zfrkrc/robocat/docs/README.md

# RoboCat dokümantasyon merkezi

| Bakmak istediğin | Belge |
|---|---|
| **Adım adım uygulama** | **[Kılavuz](KILAVUZ.md)** |
| **Kurulum (yazılım/elektronik/mekanik)** | **[Kurulum](KURULUM.md)** |
| **Parça listesi + bağlantı matrisi** | **[Bağlantı şablonu](BAGLANTI.md)** |
| Ürün ilanı metni ve görseller | [İlan paketi](SITE_ILAN.md) |
| Hedef görünüm ve gerçek CAD | [Görsel galeri](GALLERY.md) |
| Gerçek proje/donanım fotoğrafları | [20 kare + teşhis notları](BUILD_PHOTOS_2026-10-26.md) |
| Çevre sensör düğümü (ESP32) | [Bağlantı şeması ve pin tablosu](ENV_NODE.md) |
| Güncel mimari / görev dağılımı | [Sistem](SYSTEM.md) |
| Tek LiPo ve güç yolu | [Güç diyagramı](images/robocat-power.svg), [güncel güç planı](../hardware/PCB_PLAN_REV_A.md) |
| Aldığımız parçalar | [Envanter](../hardware/INVENTORY.md) |
| Pin adayları | [PINMAP_REV_A.csv](../hardware/PINMAP_REV_A.csv) |
| Ne basılacak / ne bekleyecek | [Baskı merkezi](PRINTING.md) |
| Eski sürümler ve ayrı projeler | [Arşiv merkezi](../archive/README.md) |
| Orijinal dosyalar ve lisans sınırları | [Kaynak haritası](SOURCES.md) |
| Aşamalar ve tamamlanma ölçütleri | [Yol haritası](ROADMAP.md) |

Güncel durum: mekanik uyum baskısı ve masaüstü elektronik test hazırlığı. Tam yürüyen robot, bitmiş kol veya üretilebilir PCB iddiası yoktur. Belgelerdeki mimari/pin tablosu gerçek bağlantı ve bileşen kontrollerinden önce uygulanmış devre sayılmaz.
