zfrkrc/robocat/custom/README.md

# RoboCat özel mekanik dosyaları

## Güncel girişler

| Dizin | Rol |
|---|---|
| [petg-stage-v0.5](petg-stage-v0.5/README.md) | Önce metalik PETG: altı tek-parça uyum işi, düzeltilmiş CAT06B |
| [print-fit-v0.4](print-fit-v0.4/README.md) | Genel uyum listesi ve boş LiPo tepsisi |
| [robocat-v0.3](robocat-v0.3/README.md) | Hâlâ kullanılan kafa CAD/STL/STEP kaynakları; tüm klasör baskı listesi değildir |
| [zk-v0.1](zk-v0.1/README.md) | Eski sensör ve 18650 prototipleri; güncel baskıda kullanılmaz |

Sürüm numarası daha eski diye v0.3 ve v0.4 kaynakları arşive taşınmadı: güncel göz ve baskı aşamaları bunlara başvuruyor. Dosya yolları ve script bağımlılıkları korunur.

**Baskı seçimi:** önce [v0.5 iş listesi](petg-stage-v0.5/metallic_queue.json), gerektiğinde [v0.4 manifesti](print-fit-v0.4/print_manifest.json). Klasördeki bütün STL'ler otomatik basılmaz. CAT10, BAT01 ve eski 18650 parçaları baskı dışıdır.

[Eski kaynak arşivi](../archive/README.md) · [Kurulum](../docs/KURULUM.md)
