zfrkrc/robocat/custom/zk-v0.1/README.md

# Eski RoboCat mekanik prototipleri — v0.1

**Tarihsel referans. Güncel baskı veya montaj seti değildir.**

| Dosya | Durum |
|---|---|
| `stl/03_shoulder_ultrasonic_x2.stl` | Omuz sensör braketi; nihai gövde montajı doğrulanmadı |
| `stl/04_3s_cassette_body_x2.stl` | Eski 18650 kaset gövdesi; tek LiPo kararında kullanılmaz |
| `stl/06_strap_dock_x2.stl` | Eski kaset kızağı; güncel baskıdan çıkarıldı |

STL içerikleri korunmuştur. Otomasyon bu klasörü tarayıp baskı başlatmamalıdır.

[Güncel PETG aşaması](../petg-stage-v0.5/README.md) · [Arşiv rehberi](../../archive/README.md)
