zfrkrc/robocat/Nova-SM3/STL Files/All Files/README.md

# All Files — eski / karışık referans seti

Bu dizin tarihsel kaynak olarak korunur; RoboCat'in güncel baskı listesi değildir. Eski ve güncel mekanik parçalar birlikte kullanılmamalıdır.

- Seçilen gövde seti: [SM3 Files](../SM3%20Files).
- İlk metalik PETG uyum aşaması: [v0.5](../../../custom/petg-stage-v0.5/README.md).
- Arşiv ve sürüm rehberi: [archive](../../../archive/README.md).

Mevcut STL dosyaları değiştirilmedi. Bu açıklama otomasyon için teknik bir engelleme mekanizması değildir.
