zfrkrc/robocat/docs/ROADMAP.md

# RoboCat / yol haritası

| Aşama | Mevcut durum | Tamamlanma ölçütü |
|---|---|---|
| Envanter | Sipariş listesinden kaydedildi | Fiziksel modeller/pinler/ölçüler doğrulanır |
| Baskı uyumu | Kafa parçaları CAD kontrolü, P1 kullanıcı tarafından basılıyor bildirimi | Gerçek servo, lens, kart ve vida ile kuru montaj |
| LiPo montajı | Tek LiPo kararı, boş tepsi prototipi | Gövde bağlantısı, kablo/koruma/sıkıştırmama ve titreşim kontrolü |
| Tek servo / tek bacak | Bekliyor | Kalibre yön/merkez/limit ve kararlı besleme |
| 12 bacak | Bekliyor | Destek üstünde hareket, akım/ısınma ölçümü, sonra yerde yavaş yürüyüş |
| Kameralar / merkez | Modüller envanterde, entegrasyon bekliyor | Gerçek görüntü akışı ve kontrollü hedef kaybı davranışı |
| Kol / kartvizit | Dört servo ayrıldı, mekanik tamamlanmadı | Sabit robotta erişim/tork ve yaylı uç denemesi |
| PCB | Yalnız mimari/pin planı | Test edilmiş netlist, seçili güç parçaları, şematik/PCB/ERC/DRC ve prototip |
| Koku/gaz | Sensörler envanterde | Isıl ayrım, besleme, kalibrasyon; genel koku tanıma iddiası olmadan ölçüm |

Önce mevcut modüllerle masaüstü test; sonra sonuçlara göre PCB. Yazıcıya, robota veya PCB üreticisine otomatik iş gönderildiği bu dokümantasyon güncellemesinden çıkarılmamalı.
