zfrkrc/robocat/docs/PENTEST_PROTOCOL.md

# RoboCat — pentest ajanı protokolü (v1)

`esp32.zk.net.tr` üzerindeki modül **yürüyen robot değil**, yetkili ağ testi yapan bir ajandır. Bu nedenle:

- **Yürüme komutları geçersiz:** `follow`, `hold`, `look`, `say`, `nose_extend` … bu role kapalıdır (422).
- Komut kümesi: **`scan` · `recon` · `report` · `pause` · `stop`**.
- Ajan bize **bulgu** gönderir; biz görev ve kapsam veririz.

> Kapsam (scope) zorunludur. `ROBO_PENTEST_SCOPE` tanımlı değilse **hiçbir tarama kabul edilmez** (409). Kapsam dışı hedef → **403**.

## 1) Rol bildirimi

`sync` gövdesine `role` ve `capabilities` eklenir:

```json
{"role":"pentest","capabilities":["tcp_scan","http_probe"],
 "firmware":"pentest-0.1","rssi":-55,"battery_v":11.8}
```

Sunucu role göre komut doğrular; `role` gönderilmezse `robot` varsayılır.

## 2) Görev alma

Aynı sync turu:

```json
{"commands":[{"id":12,"kind":"scan","params":{"target":"172.16.16.50","ports":"22,80,443"}}]}
```

| `kind` | `params` | Not |
|---|---|---|
| `scan` | `{"target":"10.0.0.5","ports":"22,80,443-445","mode":"tcp","max_rate":20,"timeout_ms":800}` | kapsam içinde olmalı |
| `recon` | `{"target":"zk.net.tr"}` | DNS/WHOIS/pasif |
| `report` | `{}` | özet iste |
| `pause` | `{}` | taramayı duraklat |
| `stop` | `{}` | tüm işi durdur |
| `ping` | `{}` | cihaz canlılık testi |
| `info` | `{}` | cihaz özeti (firmware, heap, uptime) |
| `led` | `{"on":true}` | durum LED'i |
| `wifi_scan` | `{"channel":6,"duration_ms":1500}` | pasif AP taraması (kanal 1–13, 200–10000 ms) |
| `reboot` | `{}` | cihazı yeniden başlat |

## 2b) Radyo testi (attack) — kontrollü uç

`attack` genel komut uçundan **geçmez** (422). Yalnız aşağıdaki zincirle çalışır:

```
1) POST /api/v1/robots/{id}/attack/arm          -> tek kullanımlık token (TTL 120 s)
2) POST /api/v1/robots/{id}/attack              {mode,bssid,channel,duration_s,token}
3) GET  /api/v1/robots/{id}/attack/status       -> aktif oturum, kalan süre, bütçe
4) POST /api/v1/robots/{id}/attack/stop         -> anında stop komutu
```

| Kontrol | Kural |
|---|---|
| Ana anahtar | `ROBO_ATTACK_ENABLE=1` değilse **403** |
| Hedef | `ROBO_ATTACK_BSSIDS` listesindeki BSSID'ler; değilse **403** |
| Token | Tek kullanım, 120 s TTL; geçersiz/kullanılmış → **401** |
| Süre | 5–`ROBO_ATTACK_MAX_S` (varsayılan 60, en çok 120) sn; aşarsa **422** |
| Eşzamanlılık | Aynı anda tek oturum; ikincisi **409** |
| Bekleme | `ROBO_ATTACK_COOLDOWN_S` (15 s) → **429** |
| Günlük bütçe | `ROBO_ATTACK_DAILY_MAX` (10) → **429** |
| E-stop | Açıkken **409**; her şey durur |
| Watchdog | Süre dolunca sunucu **stop** yollar, oturumu `expired` yapar |
| Denetim | `attack.arm/start/stop/expired` olayları `events` tablosuna yazılır |
| Hedef onayı | Panelde "Yakındaki AP'ler" listesinden seçilir (TTL 8 saat) veya `ROBO_ATTACK_BSSIDS` | 

**Hedef seçimi:** sunucu, cihazın `/scan` çıktısını `GET /api/v1/robots/{id}/nearby` ile proxy'ler
(BSSID + SSID + RSSI + kanal). Panelde **Onayla** dediğin BSSID hedef listesine girer; başka
hiçbir BSSID başlatılamaz. Cihaz URL'si env'den gelir: `ROBO_DEVICE_URLS=pentest-1:http://172.16.16.221`.

Modlar: `deauth` · `beacon` · `probe` · `rickroll` · `evil_twin`.

**Yasal/güvenlik notu:** Bu modlar kendi BSSID'lerinde kısa süreli test içindir. Deauth/beacon
yayını yakındaki cihazları da etkiler; yalnız **yazılı izin verilen** ağlarda, kısa süreyle ve
`ROBO_ATTACK_BSSIDS` listesini dar tutarak kullan. Üçüncü taraflara karşı kullanım suçtur.

Komut `ack` ile kapatılır (bir sonraki turda). TTL 30 s.

### Görev parametreleri (sunucu doğrular ve normalleştirir)

| Alan | Varsayılan | Sınır | Not |
|---|---|---|---|
| `target` | — | zorunlu | kapsam içinde olmalı (403) |
| `ports` | `22,80,443` | **≤1024 port**, 1–65535 | `"22,80,443-445"` biçimi; sunucu sıkıştırıp `port_count` ekler |
| `mode` | `tcp` | `tcp` · `http_head` | `http_head` = bağlan + `HEAD /` gönder |
| `max_rate` | `20` | 1–200 bağlantı/sn | ajanın hız sınırı |
| `timeout_ms` | `800` | 100–5000 | bağlantı zaman aşımı |

Sunucunun cihaza yolladığı normalize edilmiş örnek:

```json
{"target":"172.16.16.50","ports":"22,80,443-445","port_count":5,
 "mode":"tcp","max_rate":20,"timeout_ms":800}
```

Geçersiz parametre → **422**; kapsam dışı hedef → **403**; kapsam tanımsız → **409**.

## 3) Bulgu gönderme

```
POST /api/v1/device/{device_id}/findings
X-Device-Key: <key>
```

```json
{"items":[
  {"scan_id":"s-2026-10-27-1","target":"172.16.16.50","port":22,"proto":"tcp",
   "service":"ssh","version":"OpenSSH 8.2","severity":"medium",
   "title":"Eski OpenSSH sürümü","evidence":"banner: SSH-2.0-OpenSSH_8.2","cvss":5.3}
]}
```

| Alan | Kural |
|---|---|
| `target` | IP / alan adı (190 karaktere kadar) |
| `title` | 3–200 karakter |
| `severity` | `info` · `low` · `medium` · `high` · `critical` |
| `port` | 0–65535 (opsiyonel) |
| `evidence` | en fazla 2000 karakter — **ham çıktı, sır/PII koyma** |
| toplu | tur başına en fazla **200** kayıt |

Yanıt: `{"stored":1,"out_of_scope":0,"scope_configured":true}`

`in_scope=false` olan bulgular **silinmez**, işaretlenir (yanlış hedefe gitmeyi görürsün).

## 3b) Referans ajan

`tools/pentest_agent.py` (yalnız standart kütüphane):

```bash
python3 tools/pentest_agent.py --url https://robocat.zk.net.tr \
  --device-id pentest-1 --key <KEY> [--once] [--dry-run]
```

- TCP connect taraması + SSH/HTTP banner; **exploit yok, kimlik denemesi yok**.
- `max_rate` jeton kovasıyla uygulanır, `timeout_ms` bağlantıya geçer.
- Bulguları `POST /findings` ile gönderir, sonra `ack` verir (sonraki turda).
- `--dry-run`: ağa dokunmaz, yalnız görevi alıp `dry-run` notuyla kapatır.

## 4) Okuma

```
GET /api/v1/findings?device_id=pentest-1&severity=high&limit=100
GET /api/v1/devices            # role + capabilities + online
```

Panel: `https://robocat.zk.net.tr/` → **Pentest bulguları** tablosu.

## 5) Kapsam ayarı

```bash
# /etc/robocat/server.env
ROBO_PENTEST_SCOPE=172.16.16.0/24,zk.net.tr
sudo systemctl restart robocat-server
```
- CIDR (`10.0.0.0/24`) veya alan adı/sonek (`zk.net.tr`) yazılabilir.
- **Boş bırakılırsa tarama reddedilir** — bilinçli güvenli varsayılan.

## 6) Yetki ve sınırlar

- Yalnız **sahibi olduğun ağ/alan adları** kapsama alınmalı; üçüncü taraflara tarama yasal risk taşır.
- Anahtar cihaz bazlıdır; sızarsa `ROBO_DEVICE_KEYS` içinde döndür.
- Bulgular **kanıt** olarak ham metin tutar; parola/token/kamera görüntüsü gibi hassas veri gönderme.
- Ajan `stop` komutunu **ACK edilmese bile** uygulamalı; yerel durdurma her zaman önceliklidir.
- Sunucu tarafı bir **orkestrasyon** katmanıdır: exploit çalıştırmaz, yalnız görev verir ve sonucu saklar.
