zfrkrc/robocat/archive/README.md

# Eski kaynak arşivi

Düzenleme: 2026-10-27. Bu klasör otomatik baskı, robot firmware'i veya PCB üretim kaynağı değildir.

## Taşınan upstream projeler

| Proje | İçerik / neden burada |
|---|---|
| [Nova-SM2](upstream/Nova-SM2) | Önceki quadruped sürümü; seçilen gövde seti Nova-SM3 |
| [BlackWidow-Hexapod](upstream/BlackWidow-Hexapod) | Altı ayaklı ayrı proje |
| [RobotArm-6DOF](upstream/RobotArm-6DOF) | Ayrı altı eksenli kol; RoboCat koluna doğrulanmış aktarım değil |
| [Pot_ProtoBox](upstream/Pot_ProtoBox) | Ayrı kutu projesi |
| [Spectrum-Analyzer](upstream/Spectrum-Analyzer) | Ayrı ses/ışık projesi |

Klasörlerin mevcut dosyaları değiştirilmeden, alt dizin yapılarıyla taşındı. Eski kök yolları artık `archive/upstream/` altındadır. Git geçmişi ve kökteki [LICENSE](../LICENSE) korunur; üçüncü taraf lisans koşulları ayrıca geçerlidir. Eski indirme/yer imi yolları yerine bu indeksi kullanın.

## Yol bağımlılıkları nedeniyle yerinde tutulanlar

| Kaynak | Durum |
|---|---|
| [Nova-SM3](../Nova-SM3) | Güncel gövde ve Mega referansları burada; farklı kart/sürüm dosyaları da içerir |
| [SM3 Files-OLD](../Nova-SM3/STL%20Files/SM3%20Files-OLD/README.md) | Eski mekanik set; güncel parçalarla karıştırılmaz |
| [All Files](../Nova-SM3/STL%20Files/All%20Files/README.md) | Karışık sürüm toplaması; baskı manifesti değildir |
| [custom/zk-v0.1](../custom/zk-v0.1/README.md) | Kullanımdan çıkan 18650/sensör prototipleri |
| [custom/robocat-v0.3](../custom/robocat-v0.3/README.md) | Kafa kaynaklarının bir kısmı hâlâ güncel; toplu arşiv sayılmaz |
| [custom/print-fit-v0.4](../custom/print-fit-v0.4/README.md) | Genel uyum ve tepsi kaynakları hâlâ kullanılıyor |

**Seçilen gövde seti:** [Nova-SM3 / SM3 Files](../Nova-SM3/STL%20Files/SM3%20Files). **İlk PETG aşaması:** [v0.5](../custom/petg-stage-v0.5/README.md).

[Ana sayfa](../README.md) · [Kaynak/lisans haritası](../docs/SOURCES.md)
