zfrkrc/robocat/docs/images/robocat-architecture.png

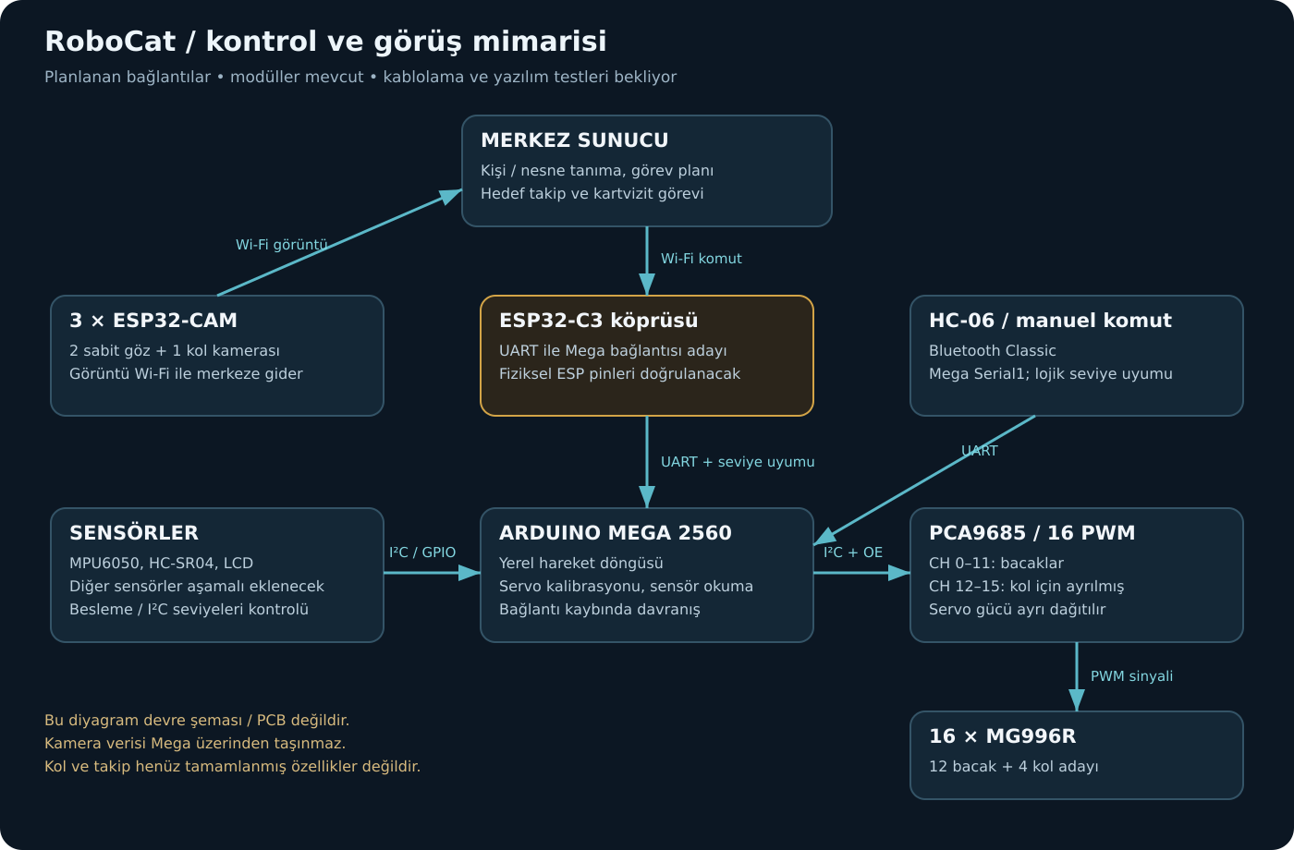
docs/images/robocat-architecture.png
