zfrkrc/robocat/docs/images/robocat-power.png

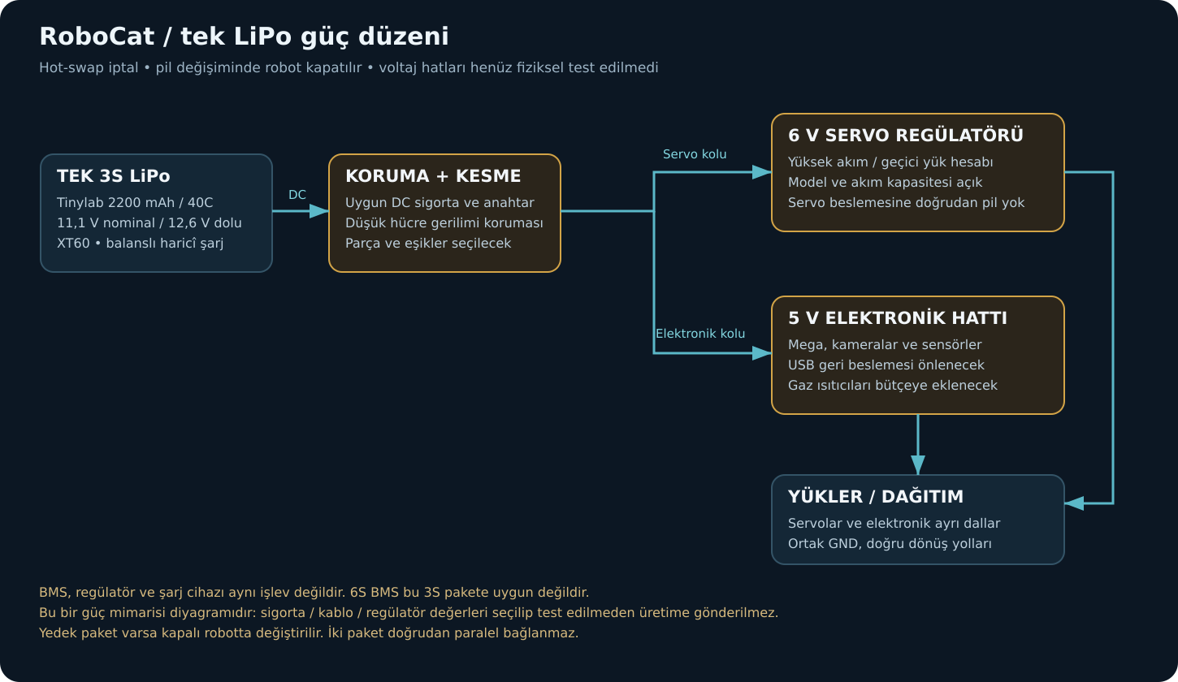
docs/images/robocat-power.png
