zfrkrc/robocat/docs/site-upload/05-esp32-cam.jpg

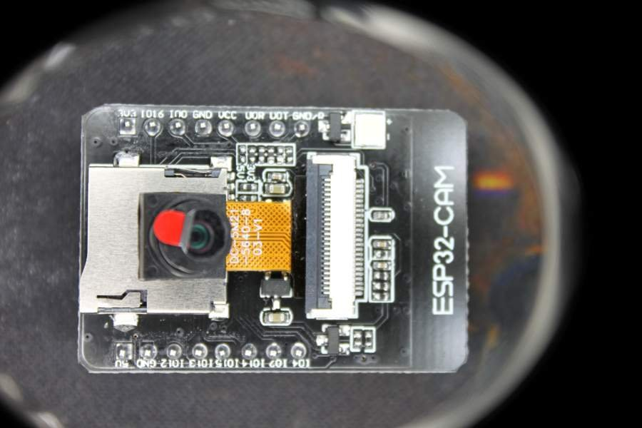
docs/site-upload/05-esp32-cam.jpg
