zfrkrc/robocat/custom/robocat-v0.3/head_assembly.step

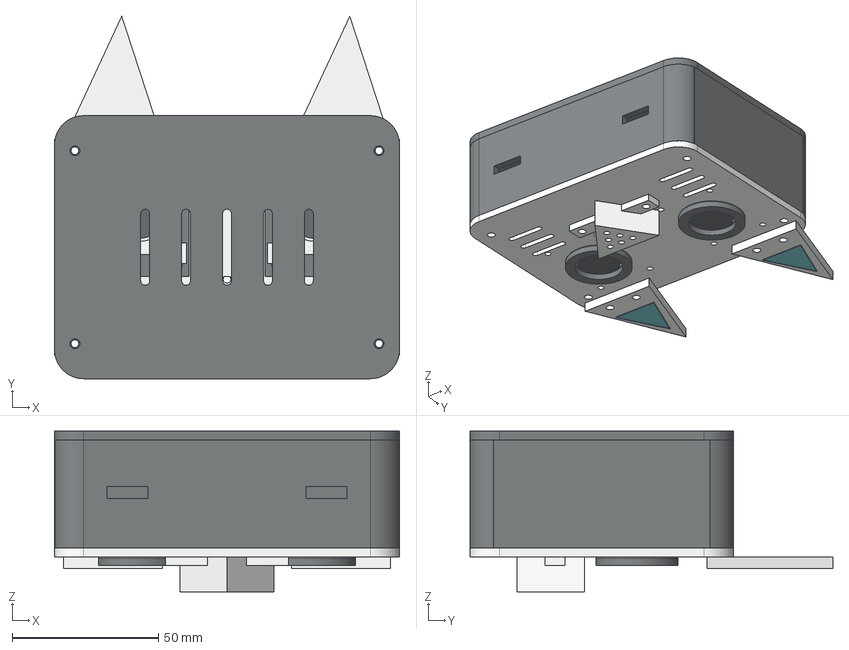
[picture p14: CAD file, 2026-10-24]
custom/robocat-v0.3/head_assembly.step
118.0 x 124.0 x 55.0 mm
rear2
ear3
insert4
ear5
insert6
ring7
lens8
carrier9
ring10
lens11
carrier12
nose13
