zfrkrc/robocat/custom/petg-stage-v0.5/stl/CAT06B_eye_bezel_7x7_boss_x2.step

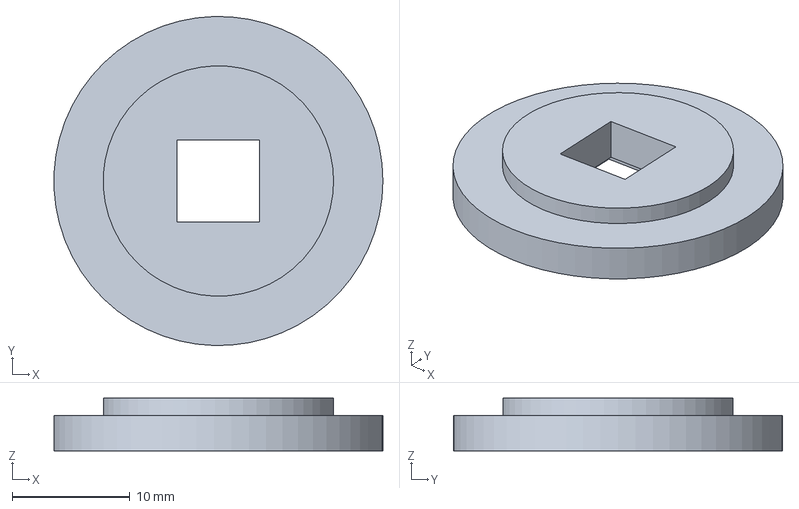
[picture p15: CAD file, 2026-10-26]
custom/petg-stage-v0.5/stl/CAT06B_eye_bezel_7x7_boss_x2.step
28.0 x 28.0 x 4.50 mm
