zfrkrc/robocat/custom/print-fit-v0.4/BAT_TEST_3S_2200_TRAY_x1.step

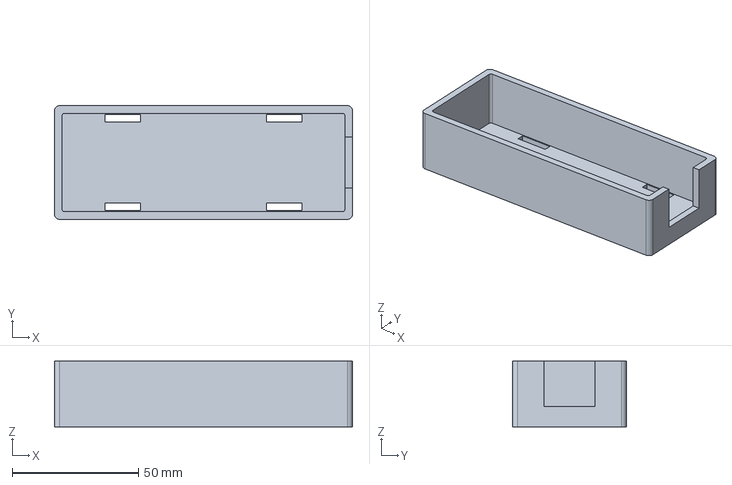
[picture p16: CAD file, 2026-10-25]
custom/print-fit-v0.4/BAT_TEST_3S_2200_TRAY_x1.step
118.0 x 45.0 x 26.0 mm
