zfrkrc/robocat/custom/zk-v0.1/stl/03_shoulder_ultrasonic_x2.stl

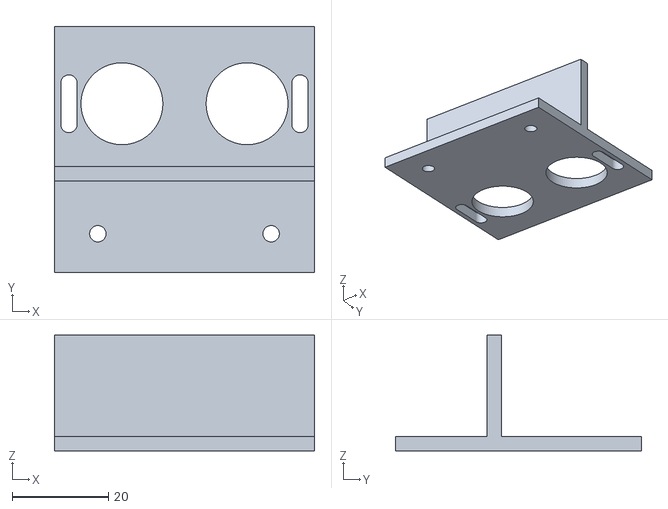
[picture p17: CAD file, 2026-10-24]
custom/zk-v0.1/stl/03_shoulder_ultrasonic_x2.stl
54.0 x 51.0 x 24.0
