zfrkrc/robocat/custom/robocat-v0.3/stl/CAT02_dark_head_shell_x1.step

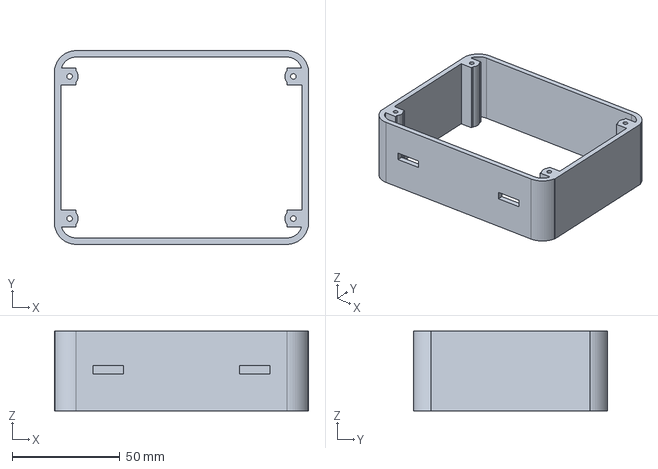
[picture p18: CAD file, 2026-10-24]
custom/robocat-v0.3/stl/CAT02_dark_head_shell_x1.step
118.0 x 90.0 x 37.0 mm
