zfrkrc/robocat/custom/zk-v0.1/stl/06_strap_dock_x2.stl

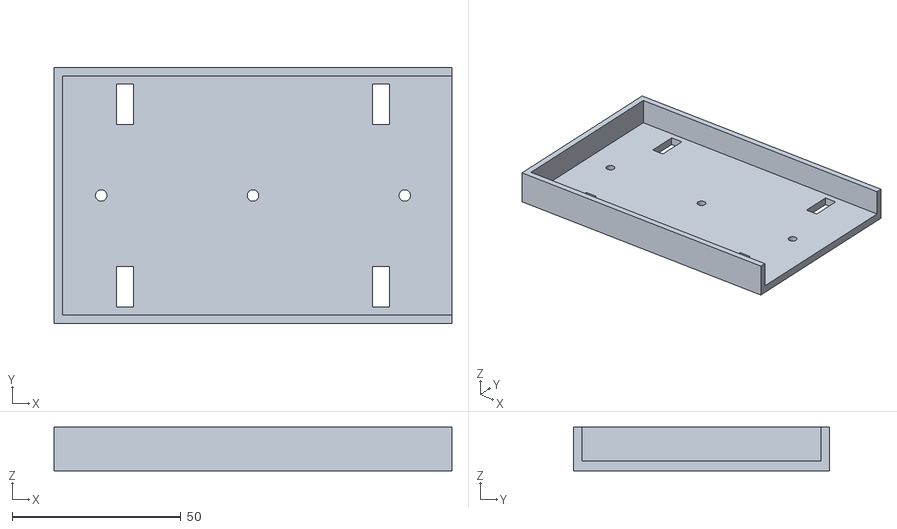
[picture p19: CAD file, 2026-10-24]
custom/zk-v0.1/stl/06_strap_dock_x2.stl
118.0 x 76.0 x 13.0
