zfrkrc/robocat/custom/robocat-v0.3/stl/CAT07_white_vented_nose_x1.step

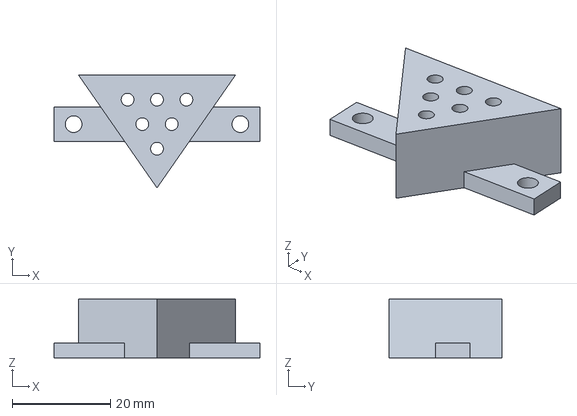
[picture p20: CAD file, 2026-10-24]
custom/robocat-v0.3/stl/CAT07_white_vented_nose_x1.step
42.0 x 23.0 x 12.0 mm
