zfrkrc/robocat/custom/zk-v0.1/stl/02_camera_cradle_x3.stl

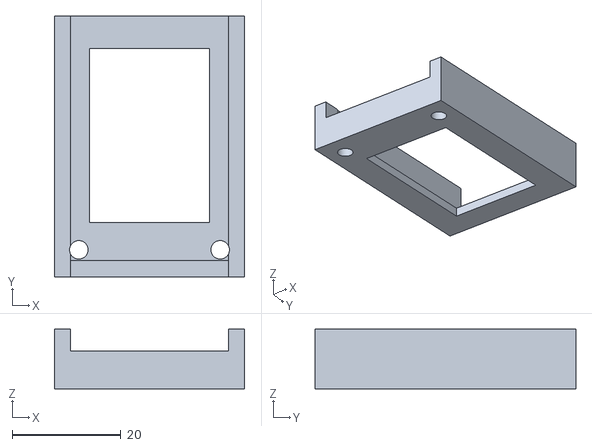
[picture p21: CAD file, 2026-10-24]
custom/zk-v0.1/stl/02_camera_cradle_x3.stl
35.0 x 48.0 x 11.0
