zfrkrc/robocat/custom/robocat-v0.3/stl/CAT08_camera_carrier_x2.step

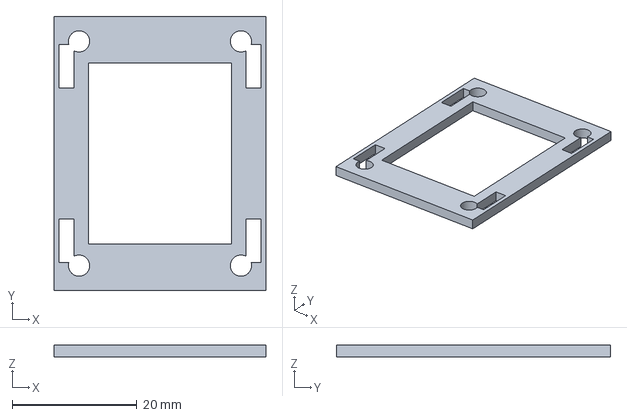
[picture p22: CAD file, 2026-10-24]
custom/robocat-v0.3/stl/CAT08_camera_carrier_x2.step
34.0 x 44.0 x 2.00 mm
