zfrkrc/robocat/custom/zk-v0.1/stl/05_3s_cassette_lid_x2.stl

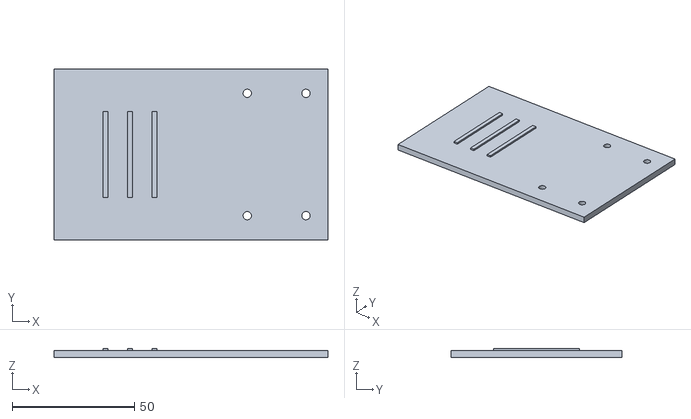
[picture p23: CAD file, 2026-10-24]
custom/zk-v0.1/stl/05_3s_cassette_lid_x2.stl
112.0 x 70.0 x 3.80
