zfrkrc/robocat/custom/robocat-v0.3/stl/TEST01_lens_coupon_x1.step

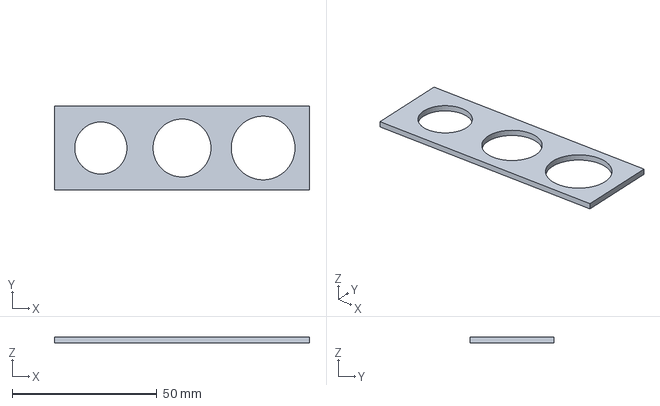
[picture p24: CAD file, 2026-10-24]
custom/robocat-v0.3/stl/TEST01_lens_coupon_x1.step
88.0 x 29.0 x 2.00 mm
