zfrkrc/robocat/custom/zk-v0.1/stl/07_face_angle_adapter_x2.stl

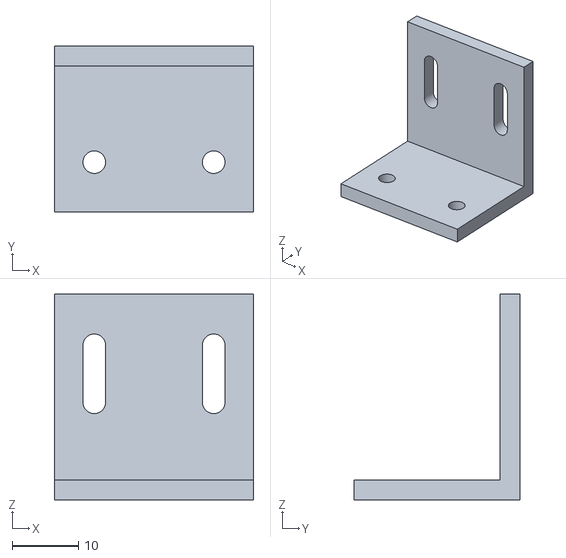
[picture p25: CAD file, 2026-10-24]
custom/zk-v0.1/stl/07_face_angle_adapter_x2.stl
30.0 x 25.0 x 31.0
