zfrkrc/robocat/custom/robocat-v0.3/stl/CAT09_camera_spacer_x8.step

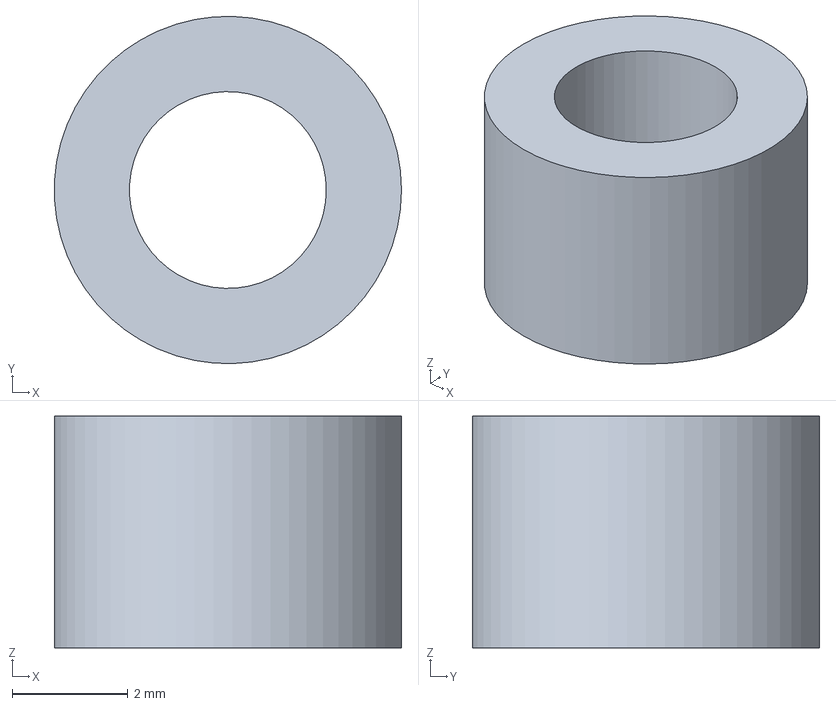
[picture p26: CAD file, 2026-10-24]
custom/robocat-v0.3/stl/CAT09_camera_spacer_x8.step
6.00 x 6.00 x 4.00 mm
