zfrkrc/robocat/custom/zk-v0.1/stl/01_fixed_face_x1.stl

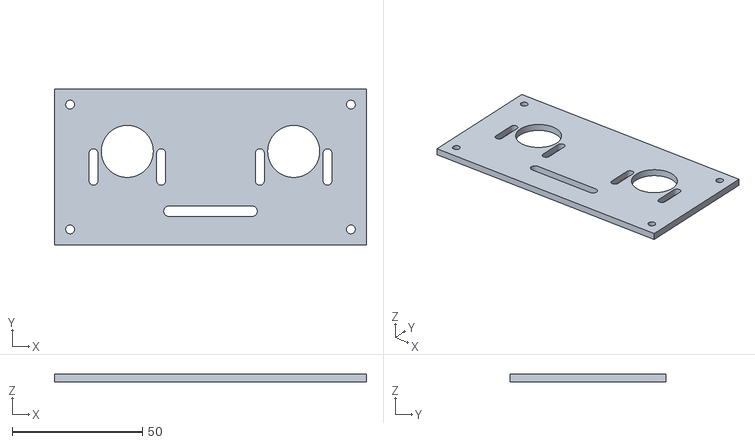
[picture p27: CAD file, 2026-10-24]
custom/zk-v0.1/stl/01_fixed_face_x1.stl
120.0 x 60.0 x 3.00
