zfrkrc/robocat/custom/robocat-v0.3/stl/CAT01_white_face_x1.step

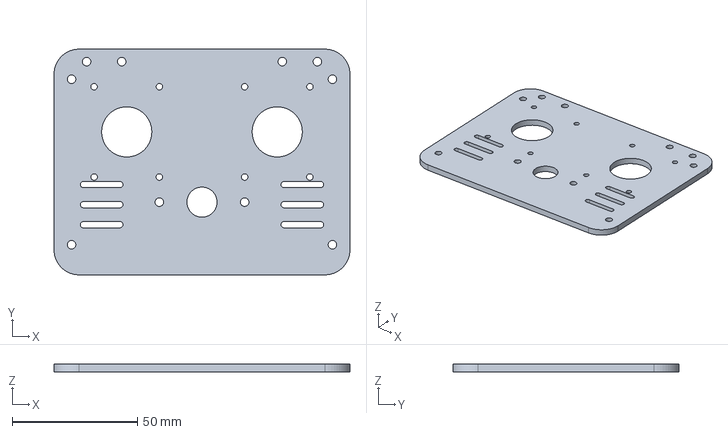
[picture p28: CAD file, 2026-10-24]
custom/robocat-v0.3/stl/CAT01_white_face_x1.step
118.0 x 90.0 x 3.00 mm
