zfrkrc/robocat/custom/zk-v0.1/stl/04_3s_cassette_body_x2.stl

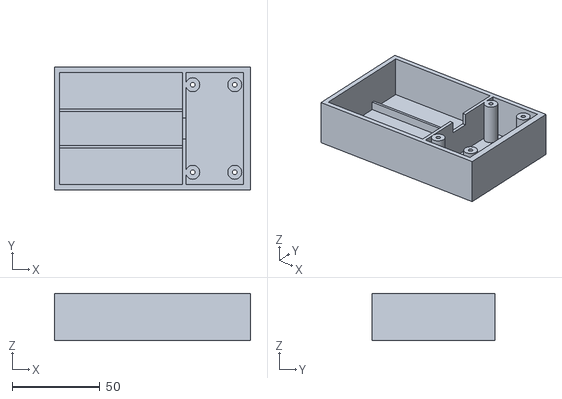
[picture p29: CAD file, 2026-10-24]
custom/zk-v0.1/stl/04_3s_cassette_body_x2.stl
112.0 x 70.0 x 27.0
