zfrkrc/robocat/custom/robocat-v0.3/stl/CAT04_white_ear_x2.step

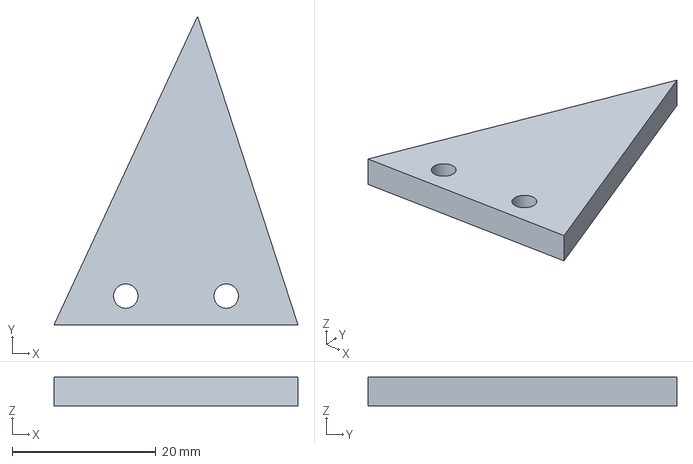
[picture p30: CAD file, 2026-10-24]
custom/robocat-v0.3/stl/CAT04_white_ear_x2.step
34.0 x 43.0 x 4.00 mm
