zfrkrc/robocat/custom/robocat-v0.3/stl/CAT10_strap_saddle_x1.step

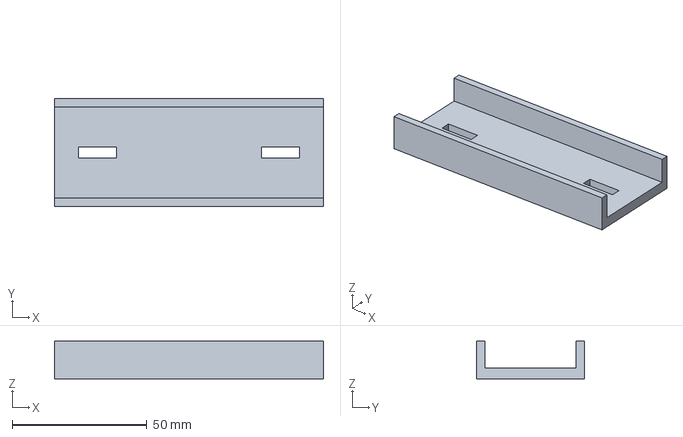
[picture p31: CAD file, 2026-10-24]
custom/robocat-v0.3/stl/CAT10_strap_saddle_x1.step
100.0 x 40.0 x 14.0 mm
