zfrkrc/robocat/custom/robocat-v0.3/stl/CAT05_teal_ear_insert_x2.step

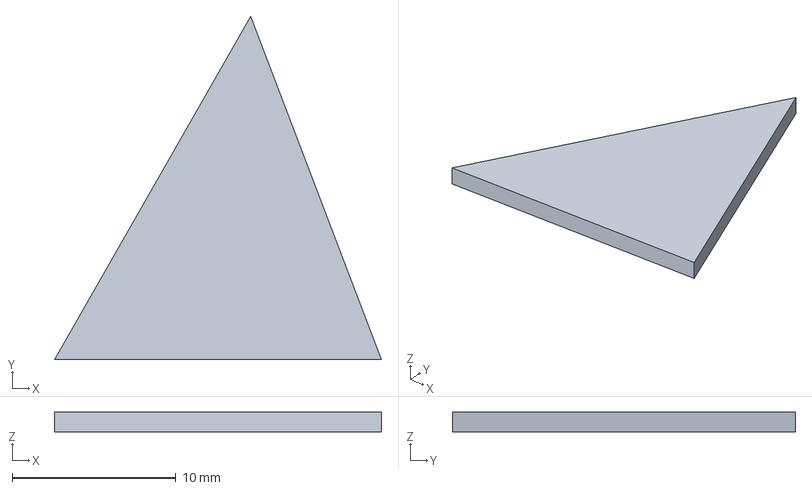
[picture p32: CAD file, 2026-10-24]
custom/robocat-v0.3/stl/CAT05_teal_ear_insert_x2.step
20.0 x 21.0 x 1.20 mm
