zfrkrc/robocat/custom/robocat-v0.3/stl/BAT01_teal_cartridge_lid_x2.step

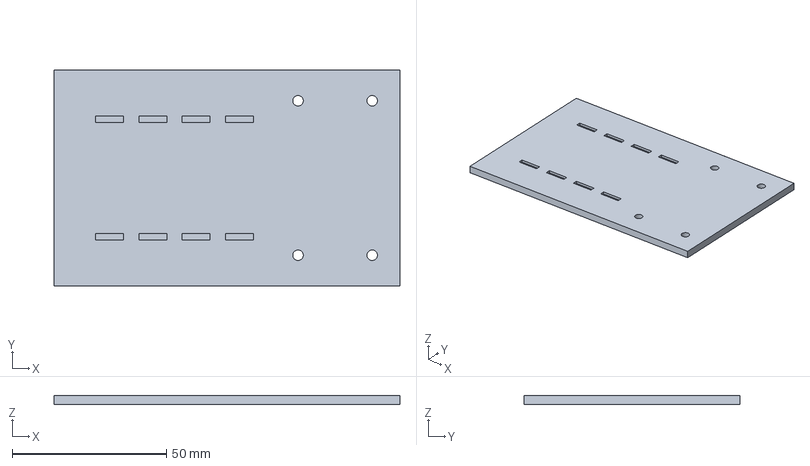
[picture p33: CAD file, 2026-10-24]
custom/robocat-v0.3/stl/BAT01_teal_cartridge_lid_x2.step
112.0 x 70.0 x 3.00 mm
