zfrkrc/robocat/custom/robocat-v0.3/stl/CAT06_dark_eye_bezel_x2.step

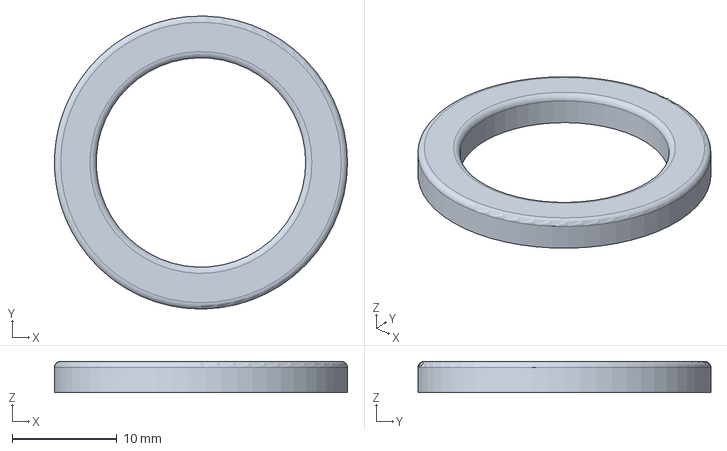
[picture p34: CAD file, 2026-10-24]
custom/robocat-v0.3/stl/CAT06_dark_eye_bezel_x2.step
28.0 x 28.0 x 3.00 mm
