zfrkrc/robocat/(list of files, cad)

Other CAD files:
custom/robocat-v0.3/stl/CAT06B_eye_bezel_7x7_boss_x2.stl
custom/robocat-v0.3/stl/CAT03_dark_rear_lid_x1.step
archive/upstream/Nova-SM2/STL Files/SM2Assembled.stl
custom/print-fit-v0.4/BAT_TEST_3S_2200_TRAY_x1.stl
custom/robocat-v0.3/stl/BAT01_teal_cartridge_lid_x2.stl
custom/robocat-v0.3/stl/CAT01_white_face_x1.stl
custom/robocat-v0.3/stl/CAT02_dark_head_shell_x1.stl
custom/robocat-v0.3/stl/CAT03_dark_rear_lid_x1.stl
custom/robocat-v0.3/stl/CAT04_white_ear_x2.stl
custom/robocat-v0.3/stl/CAT05_teal_ear_insert_x2.stl
custom/robocat-v0.3/stl/CAT06_dark_eye_bezel_x2.stl
custom/robocat-v0.3/stl/CAT07_white_vented_nose_x1.stl
custom/robocat-v0.3/stl/CAT08_camera_carrier_x2.stl
custom/robocat-v0.3/stl/CAT09_camera_spacer_x8.stl
custom/robocat-v0.3/stl/CAT10_strap_saddle_x1.stl
custom/robocat-v0.3/stl/TEST01_lens_coupon_x1.stl
