zfrkrc/robocat/docs/BUILD_PHOTOS_2026-10-26.md

# RoboCat — gerçek proje ve donanım fotoğrafları

Tarih: 2026-10-26. Kullanıcının paylaştığı 20 fotoğraf. Görseller yönü düzeltilmiş ve EXIF/konum verileri aktarılmadan web için küçültülmüştür. Orijinal dosya adı her başlıkta korunur.

Fotoğraf bir örneğin fiziksel görünümünü belgeler; siparişin tamamının teslimini, adet sayımını, elektriksel testi veya montaj uyumunu doğrulamaz. Yeni siparişlerin teslim durumları bu karelerden topluca değiştirilmedi. Tanımlanamayan kartlar kesin model gibi kaydedilmedi.

[Ana kurulum ve kabul takibi](KURULUM.md) · [Envanter](../hardware/INVENTORY.md) · [Galeri](GALLERY.md)

## IMG_9220 — Yazıcı içinde kafa parçalarının baskı aşaması

Yazıcı içinde kafa parçalarının baskı aşaması

## IMG_9221 — Yazıcı ve baskı tablasının genel görünümü

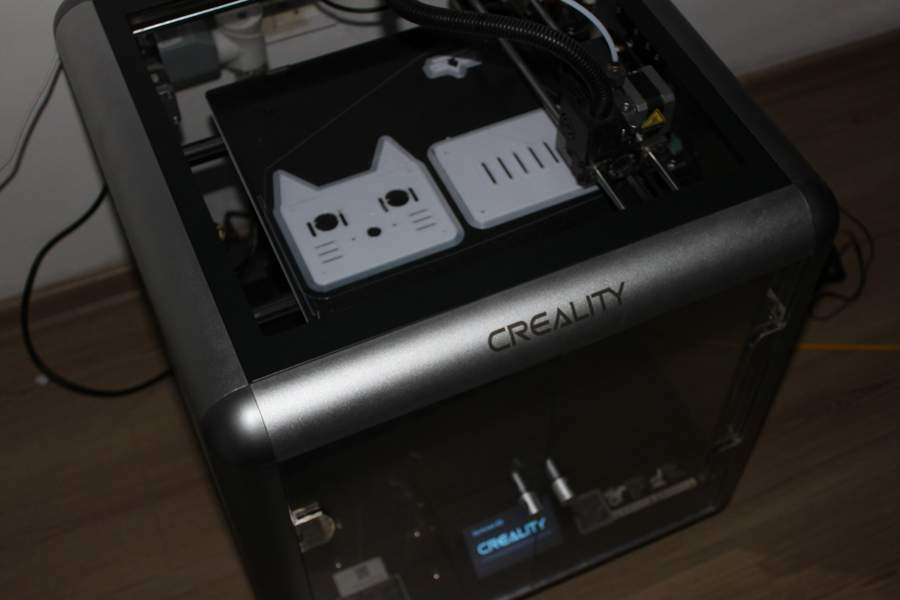
[picture p35: docs/images/build-2026-10-26/img_9221.jpg]
Yazıcı ve baskı tablasının genel görünümü


## IMG_9230 — HW-373 V1.2 1S Li-ion şarj / 5 V boost modülü — geliştirme kartı değil

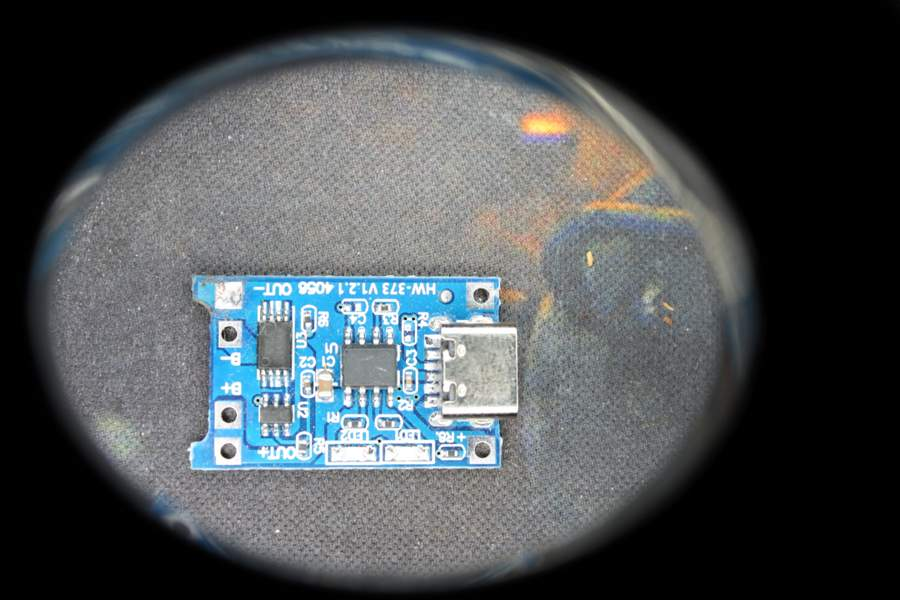
[picture p36: docs/images/build-2026-10-26/img_9230.jpg]
HW-373 V1.2 1S Li-ion şarj / 5 V boost modülü


Kart üzerindeki serigrafi **`HW-373 V1.2`** olarak okunuyor. Micro-USB girişli, **B+ / B-** pil ve **OUT+ / OUT-** çıkış pad'leri var; 8 bacaklı iki anahtarlama/protection çipi ile orta boy bir boost çipi görülüyor. Bu bir **tek hücre (1S, 3,7 V) Li-ion şarj + 5 V yükseltici (powerbank tipi) modüldür**, Arduino/geliştirme kartı değildir: ATmega, USB-seri çip, erkek header veya lojik pin yok.

- **RoboCat güç planıyla uyumsuz:** proje 3S 11,1 V 2200 mAh LiPo + 6 V servo / 5 V elektronik hattı kullanıyor. Bu kart 1S girişlidir; 3S pakete bağlanmaz.
- Tek başına 5 V deneme beslemesi olarak kullanılabilir; servo akımı, sigorta ve düşük gerilim koruması sağlamaz.
- Kesin çıkış akımı ve çip modelleri fotoğraftan doğrulanamaz; yükle test edilmeden RoboCat güç yolu sayılmaz.

## IMG_9234 — ESP32-CAM ve kamera modülü

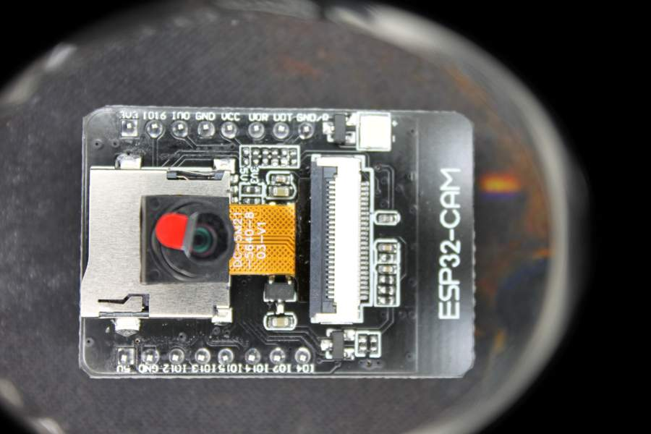
[picture p37: docs/images/build-2026-10-26/img_9234.jpg]
ESP32-CAM ve kamera modülü


## IMG_9235 — GY-521 / MPU6050 kartı

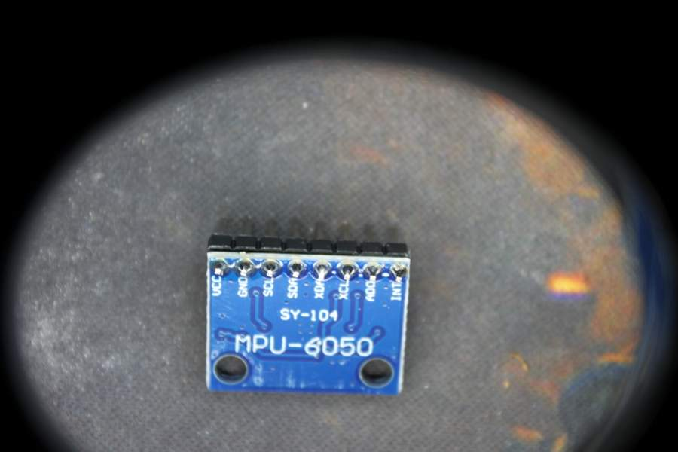
[picture p38: docs/images/build-2026-10-26/img_9235.jpg]
GY-521 / MPU6050 kartı


## IMG_9236 — Bluetooth seri modülünün arka yüzü

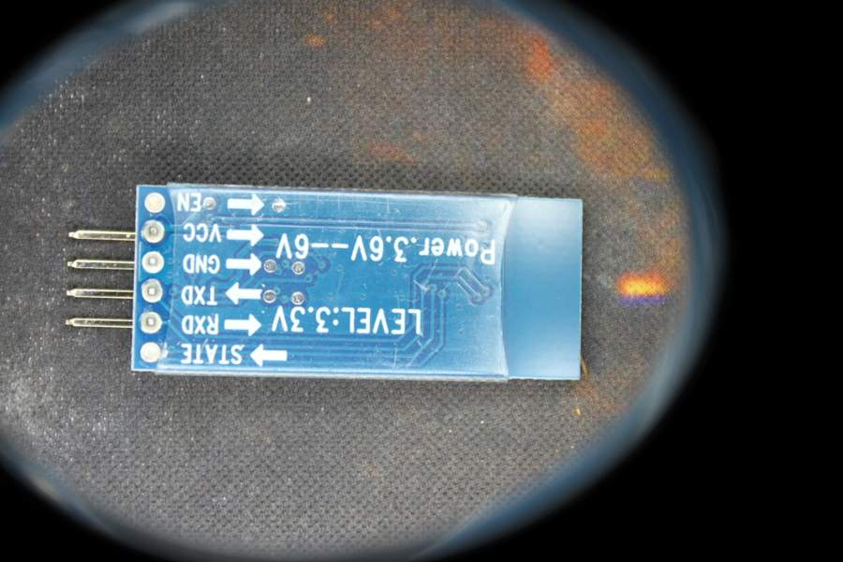
[picture p39: docs/images/build-2026-10-26/img_9236.jpg]
Bluetooth seri modülünün arka yüzü


## IMG_9237 — Bluetooth seri modülünün ön yüzü — HC-06 siparişiyle eşleştirme adayı

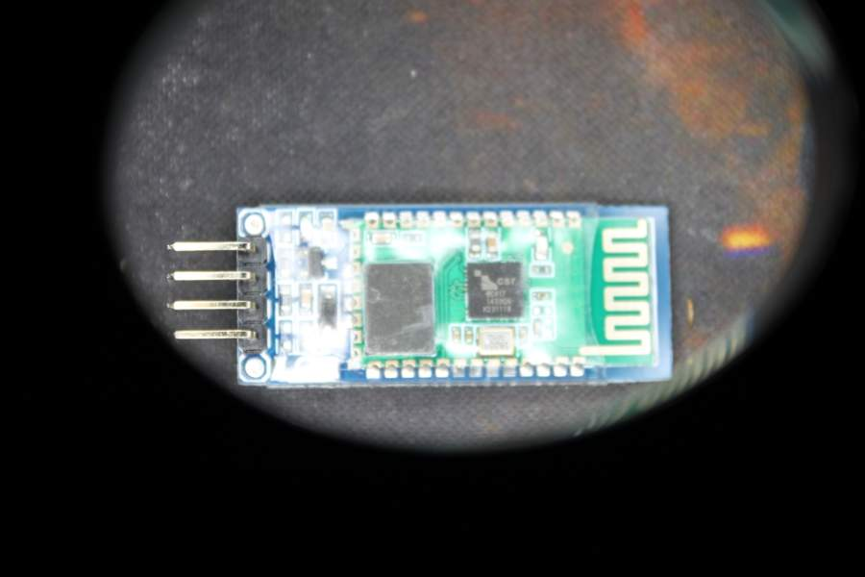
[picture p40: docs/images/build-2026-10-26/img_9237.jpg]
Bluetooth seri modülünün ön yüzü — HC-06 siparişiyle eşleştirme adayı


## IMG_9238 — T413 LDS/taret kartı — robot süpürgeden sökülmüş, RoboCat envanteri değil

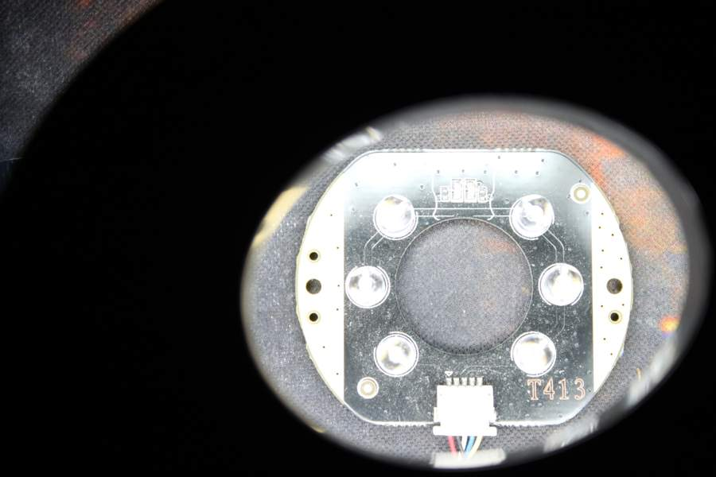
[picture p41: docs/images/build-2026-10-26/img_9238.jpg]
T413 LDS/taret kartı


Serigrafide **`T413`** yazıyor. Altı adet optik alıcı/verici ve ortada döner mekanizma boşluğu var; bu, bir robot süpürgenin **lazer mesafe/liDAR (LDS) taret kartıdır**. RoboCat'in kafa kamerası veya HC-SR04 ultrasonik hattıyla ilgisi yoktur; pinout ve sürücü entegresi bilinmiyor. Envantere alınmaz, yedek/deney parçası sayılır.

## IMG_9240 — 16×2 LCD ve I²C adaptörü

16×2 LCD ve I²C adaptörü

## IMG_9243 — SD kart modülü — ek deney donanımı

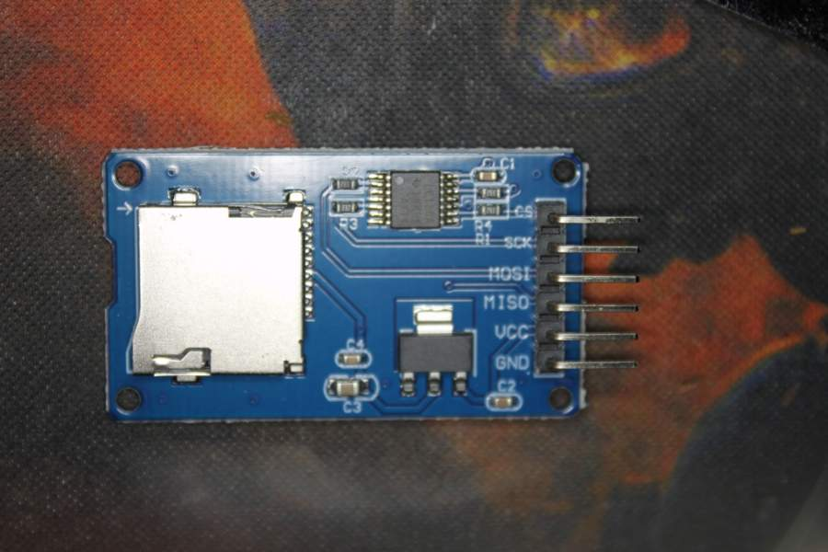
[picture p42: docs/images/build-2026-10-26/img_9243.jpg]
SD kart modülü — ek deney donanımı


## IMG_9245 — İki hoparlör — güç/empedans ve kullanım teyit bekliyor

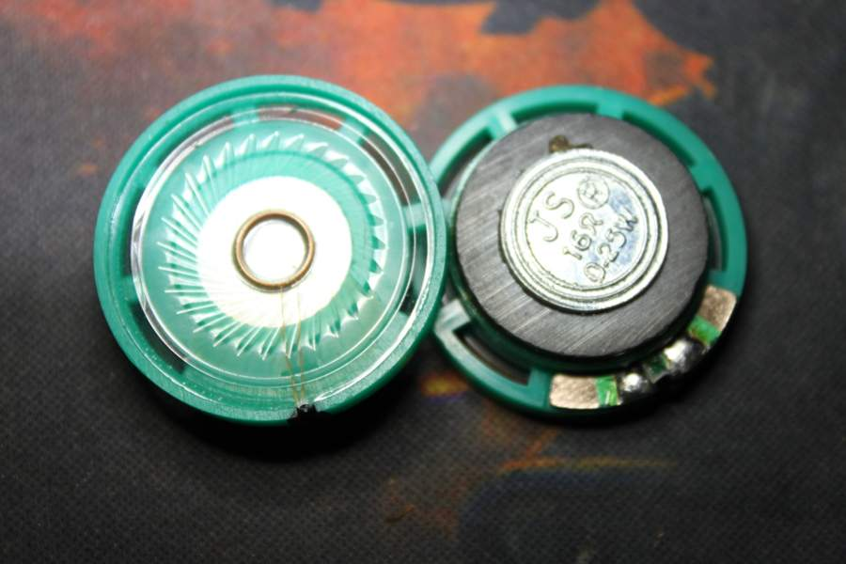
[picture p43: docs/images/build-2026-10-26/img_9245.jpg]
İki hoparlör — güç/empedans ve kullanım teyit bekliyor


## IMG_9246 — Aç/kapa anahtarı — DC akım etiketi doğrulanacak

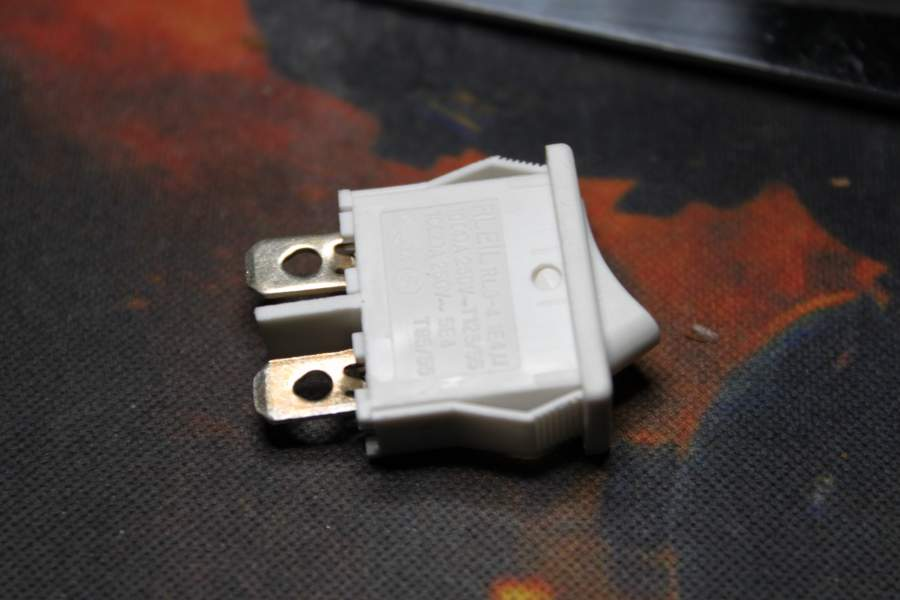
[picture p44: docs/images/build-2026-10-26/img_9246.jpg]
Aç/kapa anahtarı — DC akım etiketi doğrulanacak


## IMG_9248 — Dreame fırçasız (BLDC) motor — süpürge parçası, servo değil

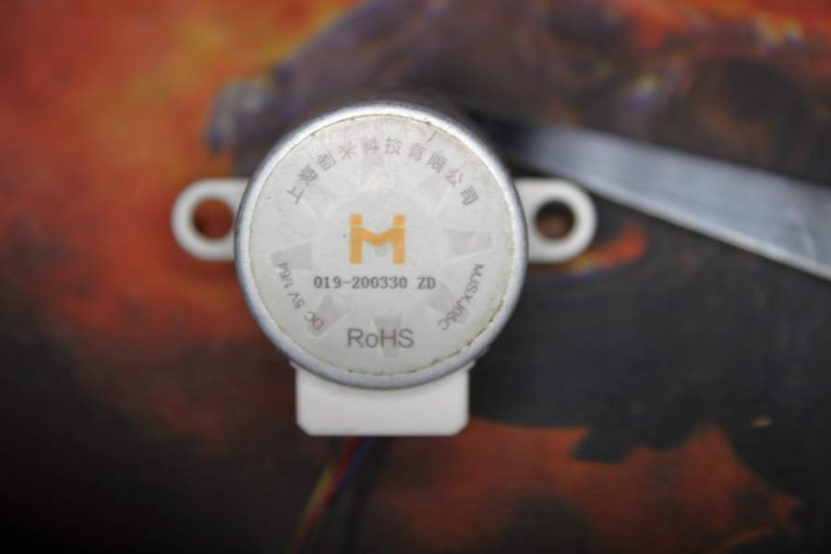
[picture p45: docs/images/build-2026-10-26/img_9248.jpg]
Dreame fırçasız motor


Gövdede **`上海追觅科技` (Shanghai Dreame Technology)** ve **`019-200330 ZD`** ile `RoHS` yazıları var. Arka tarafta 5 kablolu küçük devre kartı bulunuyor. Bu bir **fırçasız DC (BLDC) motor** adayıdır; servo değildir, PCA9685'in 50 Hz servo sinyaliyle veya tek yönlü DC sürücüyle çalışmaz. Sürmek için uygun **3 fazlı ESC/BLDC sürücü**, Hall/encoder okuma ve kapalı çevrim gerekir. Faz/Hall pinout'u ölçülmeden bağlanmamalıdır.

## IMG_9249 — MG996R servo ve çıkış mili

MG996R servo ve çıkış mili

## IMG_9251 — PRI-3605U-15260 fırçasız motor + arka kart — süpürge parçası

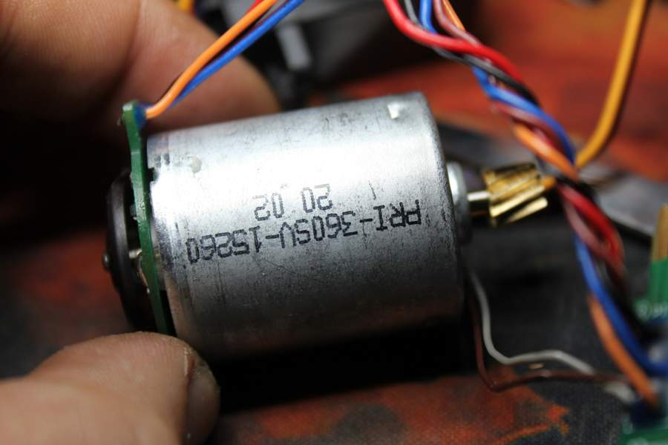
[picture p46: docs/images/build-2026-10-26/img_9251.jpg]
PRI-3605U-15260 motor


Gövdede **`PRI-3605U-15260`** ve **`20.02`** damgası okunuyor; arkasında 5 kablolu yeşil encoder/sürücü kartı ve çıkışta küçük bir dişli var. Bu da **Dreame süpürge kaynaklı, büyük olasılıkla fırçasız (BLDC)** bir motordur.

- **MG996R yerine kullanılmaz:** bacak eklemleri pozisyon kontrollü servo istiyor; bu motorun açısal referansı ve redüktör çıkışı servo gibi sabitlenmez.
- **Tahrik/deney için şartlı kullanılabilir:** sadece uygun BLDC sürücü + Hall okuma + kapalı çevrim kontrol ile. 5 kablonun hangisi faz, hangisi Hall/besleme olduğu **ölçülerek** bulunmalı; yanlış bağlama sürücüyü yakar.
- Servo sinyali (PCA9685), L298N/BTS7960 tipi basit DC sürücü veya doğrudan 3S bağlantı **uygun değildir**.

## IMG_9252 — Dreame MOTOR_CONN_B0_v2 motor bağlantı kartı — süpürge parçası

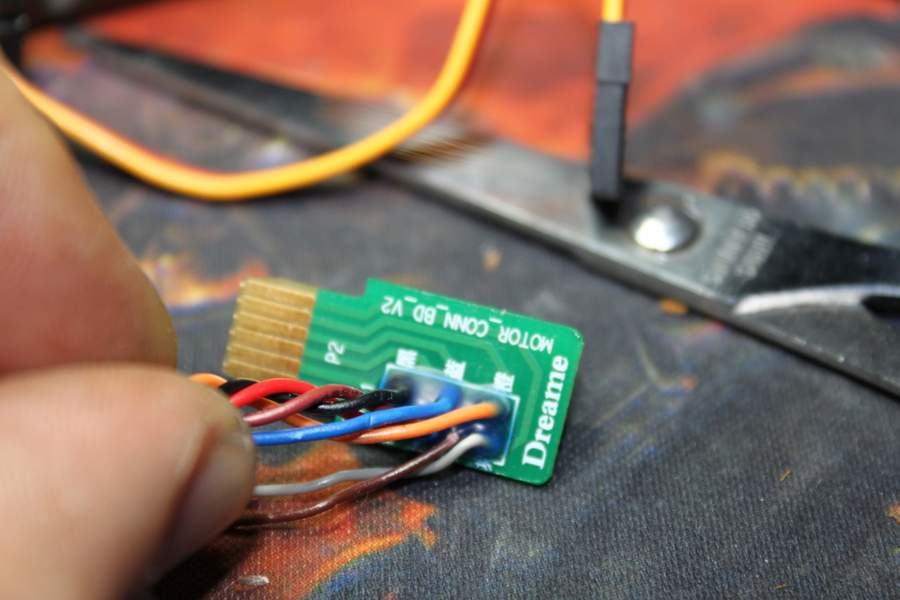
[picture p47: docs/images/build-2026-10-26/img_9252.jpg]
Dreame motor bağlantı kartı


Serigrafi **`MOTOR_CONN_B0_v2`** ve **`Dreame`** markasını gösteriyor. Sökülmüş bir robot süpürgenin motor/fırça bağlantı kartıdır; üzerindeki altın kaplama flex kontaklar aşınmış görünüyor. RoboCat BOM'una girmez, sürücü veya güç dağıtım kartı olarak kullanılamaz.

## IMG_9253 — Aynı motor bağlantı kartının soket yüzü

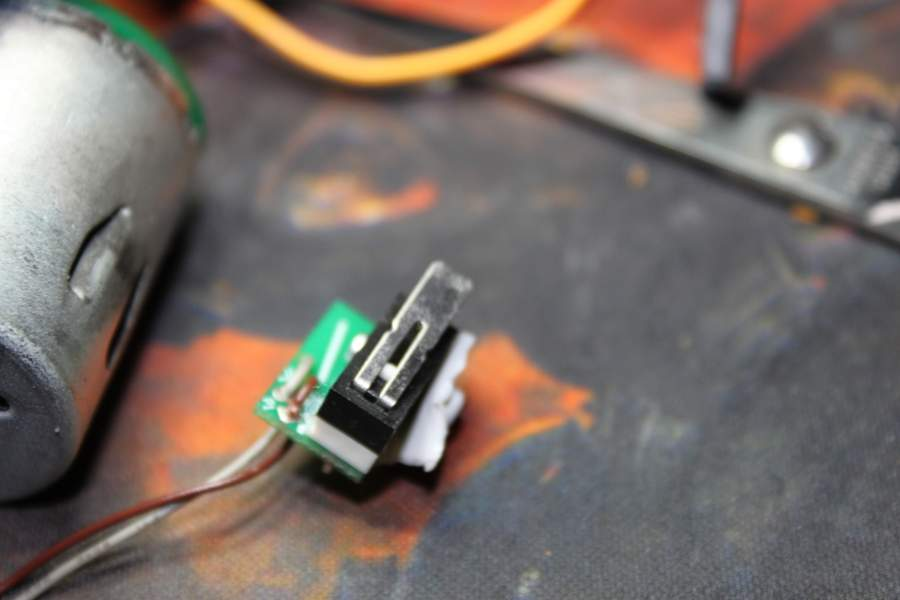
[picture p48: docs/images/build-2026-10-26/img_9253.jpg]
Motor bağlantı kartı soket yüzü


## IMG_9254 — Sökülmüş süpürge redüktörü, kart yüzü

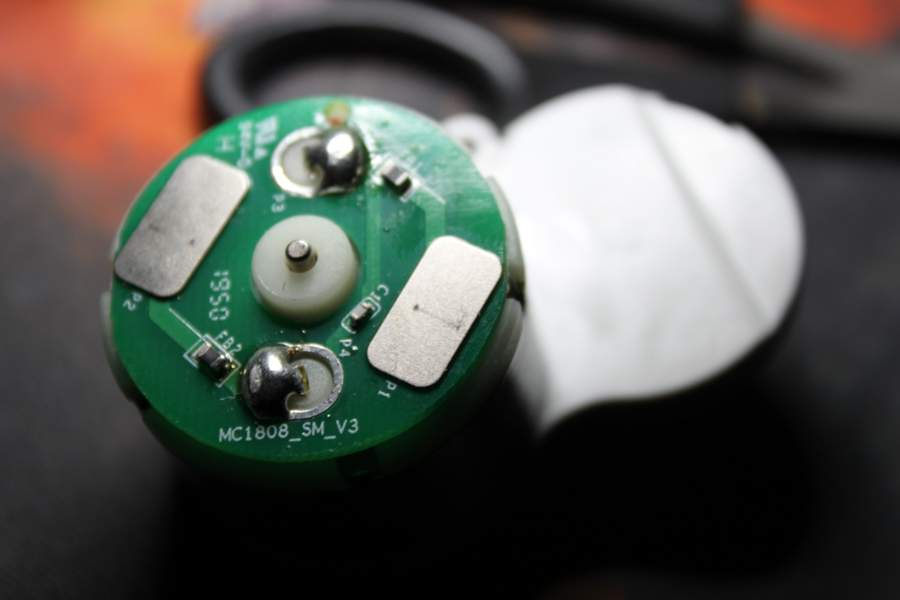
[picture p49: docs/images/build-2026-10-26/img_9254.jpg]
Sökülmüş süpürge redüktörü, kart yüzü


## IMG_9255 — Redüktör dişli grubunun iç görünümü

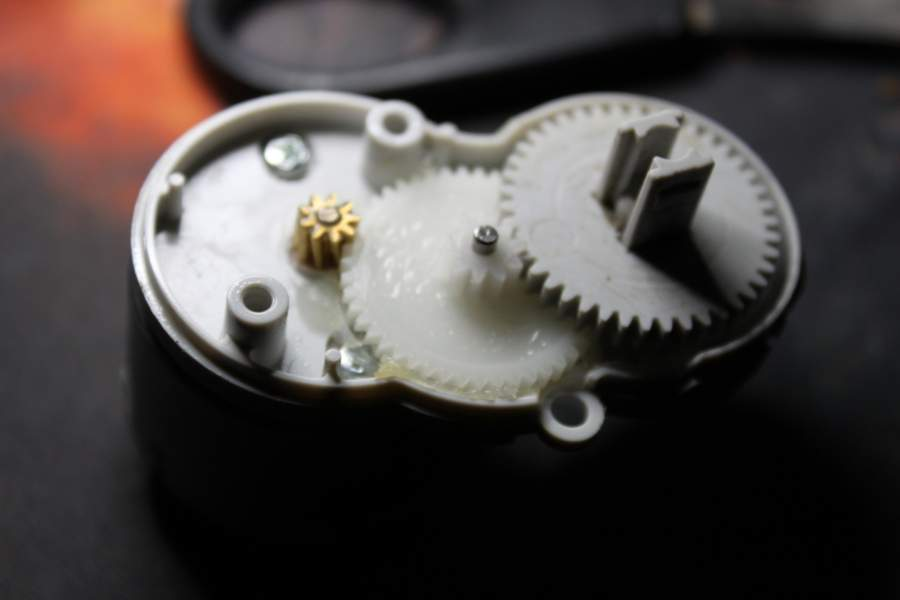
[picture p50: docs/images/build-2026-10-26/img_9255.jpg]
Redüktör dişli grubunun iç görünümü


## IMG_9256 — Motor ve redüktör çıkış detayı

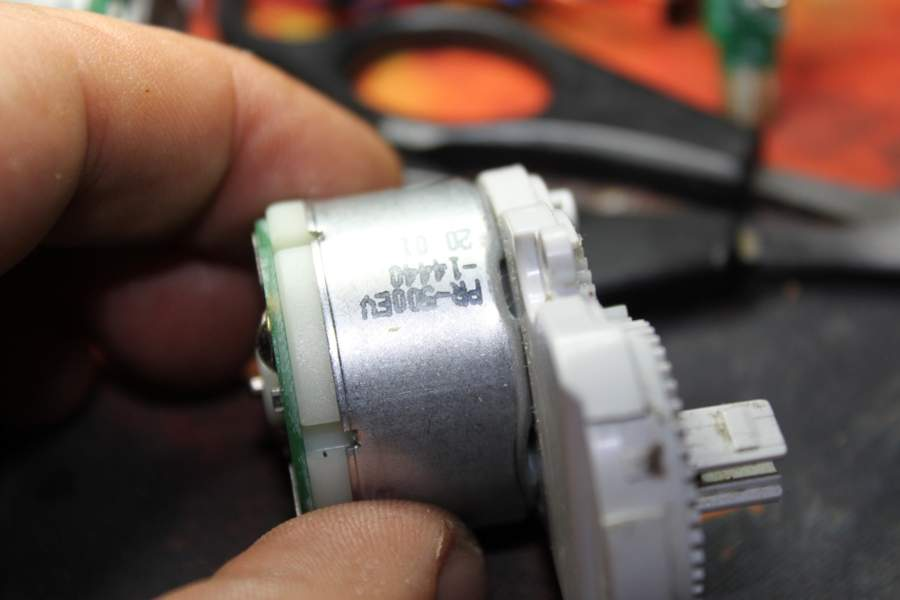
[picture p51: docs/images/build-2026-10-26/img_9256.jpg]
Motor ve redüktör çıkış detayı


## Sınıflandırma

| Grup | Fotoğraflar | RoboCat'te yeri |
|---|---|---|
| 3B baskı | IMG_9220, IMG_9221 | Baskı aşaması kaydı; kabul testi değil |
| RoboCat'e uygun elektronik | IMG_9234 (ESP32-CAM), IMG_9235 (MPU6050), IMG_9236/9237 (Bluetooth), IMG_9240 (LCD), IMG_9243 (SD), IMG_9245 (hoparlör), IMG_9246 (anahtar), IMG_9249 (MG996R) | Envanter/deney adayı; her biri ölçümle doğrulanacak |
| Güç modülü — uyumsuz | IMG_9230 (HW-373, 1S şarj + boost) | 3S planında kullanılmaz; yalnız 1S masaüstü denemesi |
| Robot süpürgeden sökülmüş parçalar | IMG_9238 (T413 LDS), IMG_9248 ve IMG_9251 (BLDC motor), IMG_9252/9253 (MOTOR_CONN kartı), IMG_9254–9256 (redüktör) | RoboCat BOM'unda yok; kaynak/yedek parça |

Bu tablo fotoğrafın ne gösterdiğini sınıflandırır; adet, teslim ve elektriksel test teyidi değildir. Model etiketi okunamayan kartlar kesin model olarak kaydedilmedi.

## Arduino ve USB-seri durumu — 2026-10-26

Aynı gün yapılan bağlantı teşhisi (fotoğraflardan bağımsız):

- Bilgisayarda `/dev/ttyUSB0` üzerinde **CH340** (`1a86:7523`) USB-seri dönüştürücü görünüyor; `ttyACM*` yok.
- 1200–250000 baud arası okumada **0 bayt**; DTR reset sonrası bootloader çıktısı yok.
- `avrdude -c arduino` ile **mega2560, atmega328p** imza okuma denemeleri **12/12 `not in sync: resp=0x00`**. Manuel reset de sonucu değiştirmedi.
- Sonuç: **Arduino Mega R3 henüz doğrulanmadı.** Ya kart bağlı değil, ya TX/GND hattı/PWR sorunlu. Fotoğraflarda da Arduino kartı yok (IMG_9230 bir güç modülüdür). Mega fiziksel olarak doğrulanana kadar yürüyüş firmware'i yüklenmiş sayılmaz.

## İlgili

- [Kurulum ve sipariş kabul takibi](KURULUM.md)
- [Envanter](../hardware/INVENTORY.md)
- [Galeri](GALLERY.md)
- [Kaynak notları](SOURCES.md)
