zfrkrc/robocat/docs/images/env-node-wiring.png

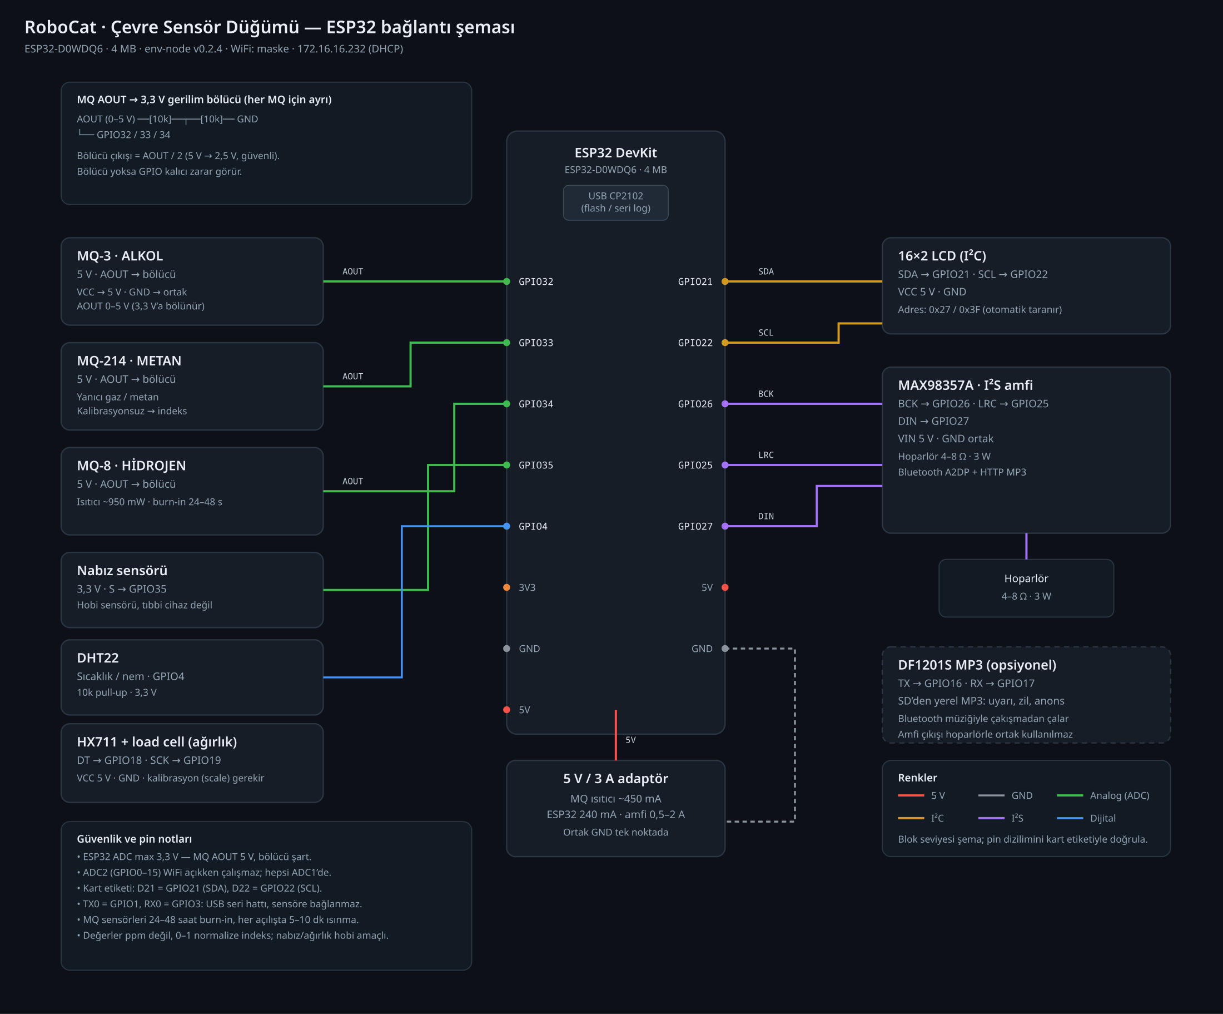
docs/images/env-node-wiring.png
