zfrkrc/robocat/(commit log)

2026-10-24 Add mechanical prototype generate.py
2026-10-24 Add mechanical prototype README.md
2026-10-24 Add mechanical prototype validation.json
2026-10-24 Add seven printable mechanical fit-test STL models
2026-10-24 Add RoboCat concept imagery and v0.3 color-separated printable head prototypes
2026-10-25 Record purchased RoboCat hardware inventory and outstanding power components
2026-10-25 Add draft RoboCat carrier architecture and 16-servo pin allocation
2026-10-25 Update single-LiPo plan and add controlled fit-test print manifest; block incompatible parts
2026-10-25 Refresh RoboCat documentation, gallery, architecture and single-LiPo diagrams
2026-10-26 Add two-colour PETG part assignment render
    Beyaz: CAT01, CAT04 x2, CAT07. Metalik: CAT02, CAT03, CAT06 x2,
    CAT08 x2, CAT09 x8, CAT05 x2, BAT_TEST, TEST01. Blocked parts
    (CAT10, BAT01, 18650) excluded per print-fit-v0.4.
2026-10-26 Add glue-in CAT06B eye bezel with 7x7 mm square aperture
    28 mm disc matching CAT06 footprint, 9x9 mm front recess, 7x7 mm
    through aperture and 19.6x1.5 mm rear centring boss for the 20 mm
    face opening. No screw features; parts are bonded. CAD only, no
    print, bond-strength or sensor-depth validation.
2026-10-26 Add step-by-step RoboCat build guide
    Consolidates status, inventory gaps, print order and two-colour
    assignment, measured servo/bearing/horn dimensions for the current
    SM3 part set, bonding rules, power path, staged bench test plan and
    troubleshooting notes. Marks unverified items explicitly.
2026-10-26 Add installation guide (software, wiring, mechanical order, checklist)
    Documents firmware/donor hardware mismatches that block a stock flash:
    TCA9548A I2C mux and PS2 receiver are expected but not in inventory
    (HC-06 only), and one PCA9685 covers exactly 16 channels. Includes
    measured horn hole spacing, bearing size, staged first power-up
    checklist and the outstanding purchase list.
2026-10-26 Add parts/BOM status and connection template
    BOM split into have / missing / blocked with measured sizes (25T horn
    10.0 mm pattern, 8x16x5 bearings, M3/M4). Mega pin matrix, PCA9685
    channel map derived from servoSetup (channels 3/7/11/15 free for arms),
    power path, firmware mismatches (TCA9548A, PS2 vs HC-06, OLED vs LCD)
    and a generated wiring block diagram.
2026-10-26 Refine wiring diagram routing
    Route 5 V logic feed around the Mega to the PCA9685 left edge and drop
    the standalone Wi-Fi polyline that crossed the servo driver box.
2026-10-26 Prepare metallic PETG fit-test stage; fuse CAT06B and preserve latest wiring guides
2026-10-26 Correct bearing spec to 625 (5x16x5)
    Measured on the current SM3 part set: bearing seat OD 15.9-16.3 mm,
    shaft/pass-through holes 5.0-5.5 mm and seat depth about 3.6-4.0 mm;
    no 8 mm bores found, so the geometry is already modelled for a 5 mm
    shaft and 625 bearings are the correct choice. Documents the ~1 mm
    proud fit and the option to ream the pocket to 5.2 mm.
2026-10-26 Add illustrated flow and assembly diagrams; refresh colour sheet for v0.5
    New build-flow and assembly-order SVGs embed into KILAVUZ/KURULUM and
    the gallery. Colour sheet now uses the fused CAT06B 7x7 bezel and the
    v0.5 metallic-first order. Bearing callouts updated to 625 (5x16x5).
2026-10-26 Track new component orders and XL4016 acceptance in setup guides
2026-10-26 Add full part catalog: 38 SM3 frame parts, 11 head parts, 1:1 hardware sheet
    Rendered every printable STL in the current SM3 set plus the v0.3/v0.5
    head parts with true bounding-box dimensions, and a uniform-scale
    drawing sheet for the purchased electronics. Gallery, parts and build
    guides link the new sheets.
2026-10-26 Correct photo identification; log Mega USB diagnosis and BOM exclusions
    - IMG_9230 is an HW-373 1S charge/boost module, not a dev board; mark 3S incompatibility
    - Identify T413 LDS board, Dreame BLDC motors and MOTOR_CONN board as vacuum parts, not BOM
    - Add photo classification table and Arduino/CH340 usb-serial test result (12/12 not in sync)
    - Link album from docs index, gallery, inventory and hardware index
2026-10-26 Mark 2026-10-26 deliveries and 625 bearings; list remaining gaps
    - Orders (TCA9548A x2, XL4016 x2, PWM driver x2, voltmeters x2, mist maker, PIR) marked delivered, tests still open
    - 625 (5x16x5) bearings recorded as obtained; pocket fit test pending
    - Split blocker lists into 'still to buy' and 'in hand, test/code pending' in KURULUM, INVENTORY, KILAVUZ, BAGLANTI
2026-10-26 Record 6 V servo regulator, XT60/wiring and servo extensions as received
    - Move the three items from 'to buy' to 'received, test pending'
    - Require staged load verification of the 6 V regulator before 12 servos
    - Remaining gaps now: 3S LiPo, charger, LVC protection, fuse/cutoff, 25T horns, M3/M4 hardware, HX711
2026-10-26 Defer aluminium horns; start with stock plastic 25T horns
    - Move 25T aluminium horn to a deferred/conditional list in inventory, setup, guide and wiring docs
    - Assembly step now uses the plastic horn shipped with MG996R; upgrade only if slipping/stripping or torque shortfall
    - Acceptance: no slip under 5 min single-leg load, no stripped splines, servo body <60 C
2026-10-26 Record 2x 3S LiPo; defer HX711; clarify LiPo alarm and fuse
    - 2x 3S 2200 mAh 40C LiPo marked received with cell/XT60 checks pending
    - Charger treated as owned/likely; buy only if not shipped or 3S balance incompatible
    - HX711 moved to deferred (load cell not required for the build)
    - Add plain-language note on why LVC alarm and DC fuse matter; flag 18-20 AWG as branch-only
2026-10-26 Add site listing package: copy and 8 upload-ready images
    - docs/SITE_ILAN.md: title, short/long copy, kit contents, specs, image order (no pricing)
    - docs/site-upload/: 8 optimized JPEGs (<=1600px) for hobby.zaferkaraca.net product 20
    - Flag listing fixes: 16 servos (not 12), card mechanism and soldered power are unverified, remove price line
    - Drop price wording from inventory
2026-10-26 Add server-side service: camera ingest, vision results, telemetry, command queue
    FastAPI v1 with SQLite storage and a single vision worker. Cameras POST
    JPEG frames (sync or queued); analyser reports quality metrics, ArUco
    markers and motion regions, with optional YOLO ONNX person boxes.
    Robots post telemetry and poll an at-least-once command queue with TTL
    and ack; server-side emergency stop gates all non-stop commands.
    Includes dashboard, Dockerfile, 9 passing tests and the v1 wire contract.
2026-10-26 Add deterministic mission engine and web controls
    Behaviour contract in docs/MISSION.md: follow by default, periodic or
    on-demand environment scan, deterministic recognition (same label in at
    least two frames; motion never counts as a person), greet, offer the
    alcohol test, extend the nose, read the sensor, report a raw value with
    an uncalibrated band, retract and resume following. Name call stops the
    robot; emergency stop overrides everything and only accepts stop.
    Adds mission state persistence, a 1 Hz timeout ticker, mission/recognize/
    scan endpoints, extra command kinds (follow, hold, say, nose_extend,
    nose_retract) and a dashboard mission panel with web JPEG upload.
    10 new tests (19 to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
2026-10-26 Add ESP8266 device sync endpoint, firmware skeleton and protocol doc
    One round trip: POST /api/v1/device/{id}/sync with X-Device-Key reports
    rssi/battery/sensors/events/acks and returns up to two claimed commands
    plus timing config. Keys come from ROBO_DEVICE_KEYS (loopback-only when
    unset), device->robot mapping from ROBO_DEVICE_ROBOTS, per-device rate
    limit. Adds a devices heartbeat table, /api/v1/devices, an Arduino
    reference bridge, 6 new tests (25 total) and the v1 device contract,
    including the current DNS state: esp32.zk.net.tr is NXDOMAIN.
2026-10-26 Expose the server publicly via a dedicated Cloudflare tunnel
    esp32.zk.net.tr now resolves to a separate locally-managed tunnel
    (robocat) that forwards to 127.0.0.1:8090; the production tunnel and its
    remotely-managed config are untouched. Adds systemd units, env template,
    deployment/rollback notes and HTTPS support in the ESP8266 sketch
    (BearSSL with an insecure-test default and pinning guidance).
2026-10-26 Log device sync calls with real client IP and user agent
    Adds an HTTP middleware that prints method, forwarded client IP, status,
    user agent and whether a device key was presented for /api/v1/device/*
    calls. The key itself is never logged.
2026-10-26 Add robocat.zk.net.tr alias to bypass the NXDOMAIN cache
    The esp32 record was created after the zone's negative cache was seeded
    (SOA minimum 1800 s), so LAN clients keep failing with name-not-resolved.
    A fresh alias on the same tunnel works immediately.
2026-10-26 Add pentest device role: scoped scan tasks and findings intake
    Devices declare role/capabilities on sync. Pentest-role devices only
    accept scan/recon/report/pause/stop; robot commands are rejected with
    422. Scans require ROBO_PENTEST_SCOPE (409 when unset, 403 outside it)
    and findings are stored with an in_scope flag instead of being dropped.
    Device auth moved into middleware so unauthorised calls fail with 401
    before body validation. Adds findings endpoints, dashboard table,
    protocol doc and 8 tests (32 total).
2026-10-26 Add scan task schema and a reference pentest agent
    Scan tasks are validated and normalised on the server (ports <=1024,
    mode tcp/http_head, max_rate 1-200, timeout 100-5000 ms) before they
    reach the device; invalid params return 422. Adds tools/pentest_agent.py,
    a stdlib-only client that runs bounded TCP connect scans, grabs SSH/HTTP
    banners, posts findings and acks (with --dry-run), plus docs and two
    tests (34 total).
2026-10-27 Refresh RoboCat landing page with current progress, workshop photos and PETG stages
2026-10-27 Organize 66 legacy upstream files into archive and label historical STL sets
2026-10-27 Report device activity and fix column mixup in device heartbeat
    Adds optional activity/progress to the sync payload, stores them with
    device_touch and derives a fallback ("scan <target>", "queued: ...",
    "idle") when a device does not send them. Rewrites device_touch with
    named parameters after a positional-argument bug wrote role into
    capabilities and activity into activity_at; the devices endpoint now
    normalises legacy rows so one bad row cannot break the list.
    Adds a regression test (35 total).
2026-10-27 Add device utility commands and backfill legacy device rows
    Pentest devices may now receive ping, info, led, wifi_scan and reboot
    with parameter validation (led requires params.on, wifi_scan channel
    1-13 and 200-10000 ms). Offensive verbs (attack/deauth/beacon_spam/
    evil_twin) stay outside the server contract and return 422. Migration
    backfills role/capabilities for pre-migration rows and the devices
    endpoint tolerates NULLs, fixing the reported 500. Three new tests
    (38 total).
2026-10-27 Add controlled radio-test (attack) chain, disabled by default
    attack is no longer a generic command. It requires an explicit arm step
    that returns a single-use 120 s token, a BSSID allowlist, the enable
    flag, and then enforces max duration, one session at a time, a cooldown,
    a daily budget and e-stop. A server-side watchdog issues stop when a
    session expires, and every arm/start/stop/expiry is written to events.
    Dashboard shows status and a stop button only. Eight new tests (46).
2026-10-27 Add operator-approved attack targets and a target picker in the dashboard
    Targets now come from the static env allowlist plus a TTL-scoped list an
    operator approves (POST/DELETE /robots/{id}/attack/targets, default 8 h).
    The arm response and status show the merged list; a start for anything
    else returns 403. The radio-test card lists approved targets, adds and
    removes them, arms and starts with mode/channel/duration, and keeps the
    stop button. Attack is enabled via env, with no static targets by
    default.
2026-10-27 Proxy the device AP scan so targets can be picked from real BSSIDs
    Adds ROBO_DEVICE_URLS and GET /robots/{id}/nearby, which fetches the
    agent's own /scan (BSSID, SSID, RSSI, channel) server-side and marks
    which entries are already approved. The radio card lists nearby APs with
    a one-click Onayla that adds the BSSID to the TTL-scoped target list, so
    the target picker is populated from real, scoped APs instead of being
    empty. Device URLs come only from env (no client-supplied URLs).
2026-10-27 Fix empty radio-test card: pick the device, not a hardcoded robot id
    The dashboard hardcoded robocat-1, so nearby/targets/attack calls hit a
    robot with no device URL and returned 404, leaving the card empty. The
    robot id is now a select populated from /api/v1/devices (defaults to the
    online device, remembers the choice) and refreshes the panels on change.
    The dashboard is served with Cache-Control: no-store so a stale UI cannot
    hide these fixes.
2026-10-27 Alias the only configured device URL and stop caching API responses
    A request for a robot without its own ROBO_DEVICE_URLS entry now falls
    back to the single configured device, so a stale page pointing at
    robocat-1 still gets real APs. All /api responses are sent with
    Cache-Control: no-store; the dashboard carries a UI-2 badge so a stale
    page is obvious.
2026-10-27 Send attack mode as type/dur too, matching the agent's local API
    The device rejected attack commands with 'bilinmeyen tur' because it
    reads type and dur (same keys as its /attack?action=start endpoint).
    Commands now carry mode/type and duration_s/dur, keeping the server-side
    fields for audit.
2026-10-27 Add ESP32 environment sensor node wiring diagram and pin map
    - docs/images/env-node-wiring.svg + PNG: ESP32-D0WDQ6 with MQ-3/MQ-214/MQ-8 via dividers, pulse, DHT22, I2C LCD, MAX98357A I2S, optional DF1201S
    - docs/ENV_NODE.md: pin table, ADC1/3.3V divider rules, power budget, sensor caveats, endpoints, next steps
    - Link from docs index
2026-10-27 Env node v0.2.4: DHT22 + HX711, LCD auto-scan, pin label notes
    - Add temp/humidity and load-cell (HX711) cards and LCD page to the node doc
    - Document D21/D22 vs TX0/RX0 labels and LCD troubleshooting
    - Wiring diagram: HX711 block, pin-label notes, current IP/firmware
